WithASideOfSalt/EE475-ORBITS/README.md

# EE475-ORBITS
Development Repository for EE475 ORBITS project, design and implementation
