WithASideOfSalt/EE475-ORBITS/Design/Report/DesignReport.tex

\documentclass[a4paper,12pt,titlepage]{report}
\usepackage{titling}
\usepackage{amsmath,amssymb}
\usepackage{graphicx}
\usepackage[left=20mm,right=20mm,top=15mm,bottom=15mm]{geometry}
\usepackage{caption}
\usepackage{subcaption}
\usepackage{siunitx} % For clean units formatting
\usepackage{titlepic}
\usepackage{ragged2e}
\usepackage{pdflscape}
\usepackage{hyperref}
\usepackage{caption}
\usepackage{pdfpages}
\usepackage{tikz}
\usepackage[toc, page]{appendix}

\usepackage[backend=biber]{biblatex}
\addbibresource{references.bib}

\usepackage{chngcntr}
\counterwithout{figure}{chapter}
\counterwithout{table}{chapter}
\counterwithout{equation}{chapter}

\usepackage{listings}
\usepackage{xcolor}

\counterwithout{figure}{chapter}
\counterwithout{table}{chapter}
\counterwithout{equation}{chapter}

% --- Title Info ---
\title{EE475 - ORBITS Design}
\author{Scott McBride --- 202215222}
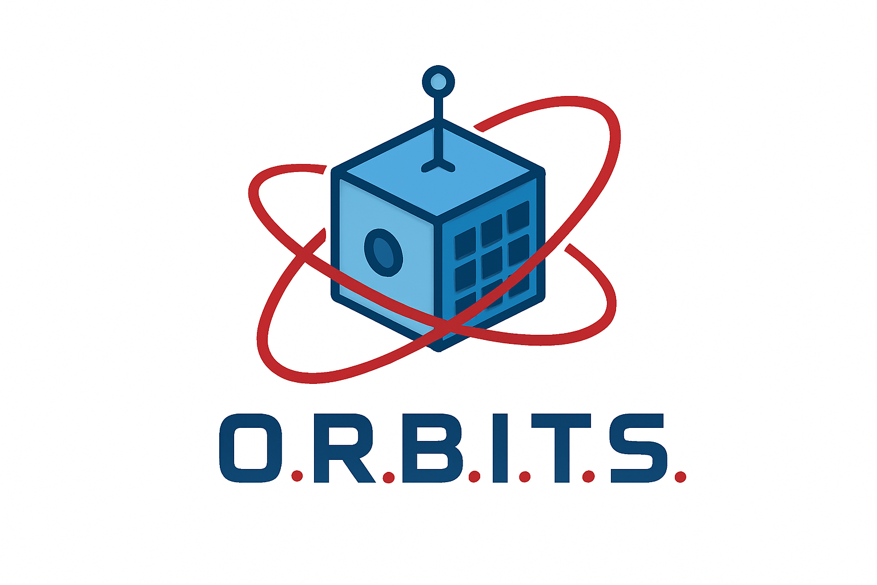
[picture p1: Design/Report/Images/ORBITS_Logo.png]
\titlepic{}
\date{\today}

\begin{document}
\begin{titlepage}
    \begin{center}
        \vspace*{3cm}
        \begin{minipage}{0.8\textwidth}
            \justifying
            \noindent \color{gray}
            I hereby declare that this work has not been submitted for any other degree/course at this University or any other institution and that, except where reference is made to the work of other authors, the material presented is original and entirely the result of my own work at the University of Strathclyde under the supervision of Dr Astrid A Werkmeister.”
        \end{minipage}
        \vfill
        \Huge
        \textbf{ORBITS}
            
        \vspace{0.5cm}
        \LARGE
        Outreach and Research Build for Interactively Teaching Satellites
            
        \vspace{1.5cm}
            
        \begin{figure}[!h]
            \centering
            \begin{minipage}{0.4\textwidth}
                \centering
                
            \end{minipage}
            \begin{minipage}{0.4\textwidth}
                \centering
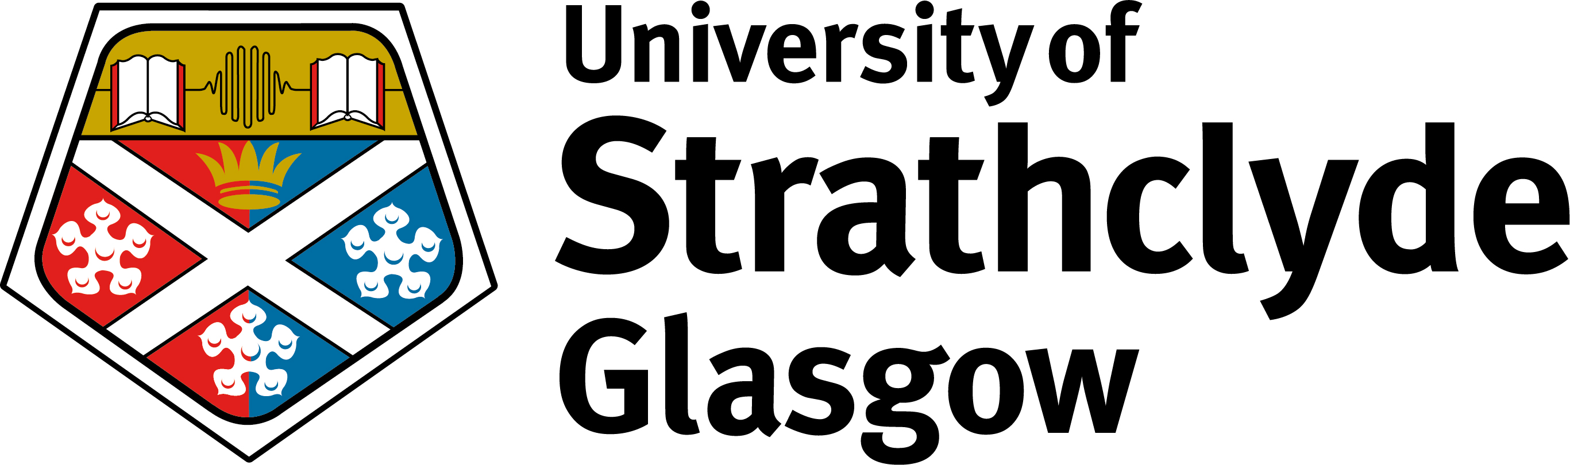
[picture p2: Design/Report/Images/strath_main.jpg]
                
            \end{minipage}
        \end{figure}  

        \textbf{Scott McBride} \\
        Dr Astrid A Werkmeister\\

        \vspace{0.8cm}
            
        \Large
        Department of Electronic and Electrical Engineering\\
        University of Strathclyde\\
        \today
            
    \end{center}
\end{titlepage}
\tableofcontents
\newpage
{\Huge\textbf{Acronyms}}
\begin{table}[h]
    \centering
    \begin{tabular}{|c|c|}
    \hline
    \textbf{Acronym}&\textbf{Meaning}\\
    ADCS & Attitude Determination and Control Subsystem \\
    API & Application Programming Interface \\
    BDD & Block Definition Diagram \\
    BLE & Bluetooth Low Energy \\
    COTS & Commercial Off The Shelf \\
    GPIO & General Purpose Input/Output \\
    I2C & Inter-Integrated Circuit \\
    IMU & Inertial Measurement Unit \\
    OBC & On-Board Computer \\
    PCB & Printed Circuit Board \\
    PMAD & Power Management and Distribution Subsystem \\
    RF & Radio Frequency \\
    SPI & Serial Peripheral Interface \\
    SysML & Systems Modelling Language \\
    UART & Universal Asynchronous Receiver-Transmitter \\
    UML & Unified Modeling Language \\
    \hline
    \end{tabular}
\end{table}
\chapter{Abstract}
The Outreach and Research Build for Interactively Teaching Satellites, referred to as ORBITS herein, is an emulation system for a 1U CubeSat ecosystem including both a ground communication station and a physical ORBITS unit that provides a learning environment for both software and hardware concepts.

The ORBITS project is looking to develop a class-based learning material that pupils, students, teachers and lecturers are able to gain hands-on experience with to experiment, learn and research into CubeSat development. The ORBITS system looks to have modularity at the forefront of its design, allowing users to create their own payloads to interact with a stock unit to learn about different aspects of a CubeSat system and development. The system looks to be comprised of Commercial Off The Shelf (COTS) components where possible to keep costs low and allow for easy replacement of faulty parts.

Where applicable SysML diagrams have been used to represent the design of the ORBITS system to describe and provide an alternative method of understanding for users to reference.

\chapter{Introduction}

The Space industry around Scotland looks to increase the number of employees to \(20,000\) and targeting \pounds 4 billion in global market share by 2030~\cite{govScot}. To meet this growth within the industry high quality educational materials are needed to introduce young individuals to what they may be working on within the industry.

ORBITS, the Outreach and Research Build for Interactively Teaching Satellites, is a developmental tool for students to learn about satellite systems and their operation through physical experimentation and learning. The particular type of satellite being emulated by this device is a 1U CubeSat, a standardised type of nanosatellite that is becoming increasingly popular for its low cost and accessibility for companies and educational institutions to develop and launch their own satellites.

ORBITS provides both the software and hardware learning solutions to best prepare those looking for a career in the space industry and inspire those looking to learn about space and satellite systems. The system is designed to be modular allowing for users to create their own payloads to interact with a stock unit to learn about different aspects of a CubeSat system and development. COTS components are used throughout the design of this system to keep costs low and simplify maintenance. 

The system provides a seamless user experience from any standard laptop or desktop environment through a ground station that links to the ORBITS unit mimicking a real-world remote satellite communication network. This provides both a software development environment and a source for the learning materials for the system.

This report covers a review of related work, requirement definition, hardware design, software design and prototype evaluation.

\section{Project Objectives}

Outlined in Table \ref{tab:project_objectives} are the project objectives for the ORBITS project. These objectives were defined through consultation with the teaching staff most likely to be interacting with these systems within a classroom environment and seeing common sticking points with integrating new projects within the class, like time for set-up, ease of use during learning and both debugging of hardware and software related issues. These objectives were then prioritised based on their importance to the overall project and the learning experience of users. The major objectives are those that are essential for the functionality of the system and the learning experience, while the minor and optional objectives are those that would enhance the system but are not essential for its core functionality.

\begin{table}[h]
\centering
\caption{ORBITS Project Objectives}
\label{tab:project_objectives}
\begin{tabular}{|p{10cm}|c|}
\hline
\textbf{Project Objective} & \textbf{Importance} \\ \hline
Provide a prototype ORBITS unit composed of Commercial Off the Shelf (COTS) components where possible. & Major \\ \hline
Provide pilot demonstrations that shall showcase the functionality and purpose of the satellites that ORBITS has been made to emulate. Use understanding of EE105 learning outcomes to aid in project aims and objectives. & Major \\ \hline
Provide a ``Base Station'', a way of communicating between a standard electronic device and the ORBITS unit. & Major \\ \hline
Provide relevant software to reduce the barrier of entry to use the product. & Major \\ \hline
Develop and design both software and hardware architecture for systems and decompose into relevant subsystems. & Major \\ \hline
Provide product documentation to allow ease of future work based upon this project. & Major \\ \hline
Provide ``Hot Swappable'' modules each with a payload with functionality related to the space industry. & Minor \\ \hline
Provide additional, more complicated modules to aid in the experimentation of different concepts. & Optional \\ \hline
Provide a viability study into how a product like this could break out into market, creating a financial incentive for future work. & Optional \\ \hline
\end{tabular}
\end{table}

\chapter{Review of Related Work}

Firstly, it is important to understand what a CubeSat actually is and why they are important for the space industry. A CubeSat is a type of nanosatellite that is typically constructed in standard units of 10 cm x 10 cm x 11.35 cm, known as 1U. The reason for this standardisation is to allow for easier development and launch of these satellites as they can fit within a standardised deployment mechanism. These devices are typically launched to low orbit (\(<2000\) km \cite{LEO}).

CubeSats were first developed at the California Polytechnic State University, San Luis Obispo and Stanford University's Space Systems Development Lab in 1999 \cite{cubesat_org}. Using this initial work as a basis, the CubeSat standard was developed and released in 2004 with over 2900 CubeSat missions launched as of January 1st 2026 \cite{nanoSats_eu}. Shown in Figure \ref{fig:CubeSat_Missions} is a visual representation of the growth in CubeSat missions over time.

\begin{figure}[h]
    \centering
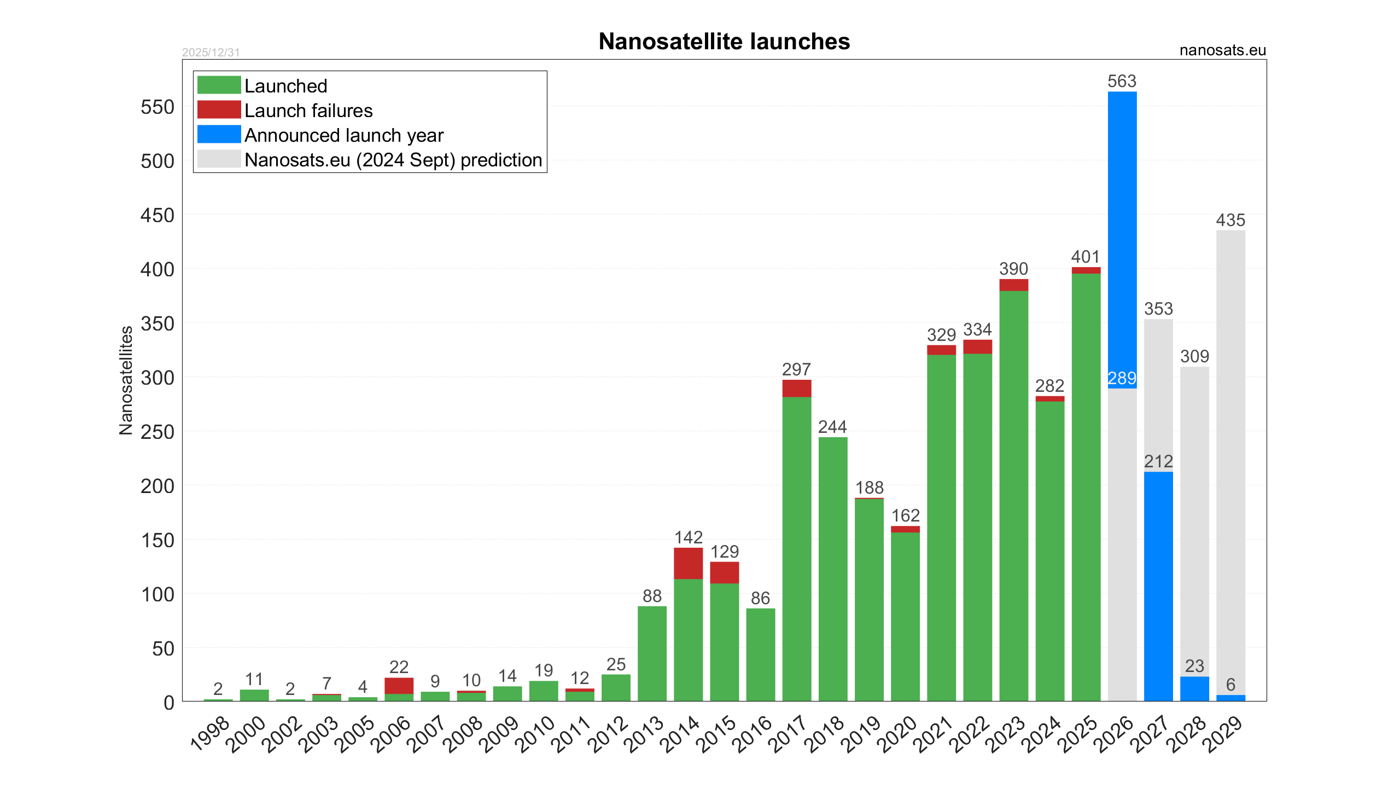
[picture p3: Design/Report/Images/CubeSat_Missions.png]
    
    \caption{Growth in CubeSat Missions over time~\cite{nanoSats_eu}}
    \label{fig:CubeSat_Missions}
\end{figure}

This standard has allowed for the development of CubeSats to be more accessible for companies and educational institutions to develop and launch their own satellites. The CubeSat standard has also allowed for the development of a wide range of different types of CubeSats including those for Earth observation, communication, technology demonstration and scientific research.

CubeSats have become increasingly popular for their educational institutions due to the low cost nature of the development of these satellites with projects like the EduCube \cite{EduCube_1U} and UBO \cite{UBO} projects. These projects looked to provide Masters students hands on experience developing and learning with physical hardware based on usable standards within the industry. These projects have been successfully implemented into academia, and look to emulate every minute detail of a space ready model. This complexity relegates these types of projects for final year students with many hours of learning and research within the field.

To further increase the scope of teaching CubeSats a few criteria should be considered. The cost of the hardware, the amount of learning materials and the extensibility of functionality are all important when it comes to the development of such devices.

Products that look at the commercial and educational markets do exist on the market already, however they are often either very expensive, don't provide a ground station to satellite link or both. Take the Ukrainian made MySat for example~\cite{MySat}, a 1U CubeSat emulator that provides a physical unit for users to interact with and construct themselves. However it is quite expensive at around \pounds 300 for the kit targeted to universities and the main method of interaction is directly to the unit rather than from a ground station connection. This means that users are limited in the software development they can do with the unit and are not able to experience the full satellite development process.

Another example is the Australian made RASCube~\cite{RASCube}, a 1U CubeSat that provides field tested hardware within the design. The RASCube provides extensive learning materials and functionality but due to the nature of being designed from the ground up with completely custom PCBs the cost of a unit including all of the learning materials is around \pounds 1000 for a singular kit which may not be accessible for many educational institutions and individuals looking to learn about satellite systems. Despite this price point, the feature set and demand for high quality learning has driven more than 1400 kits sold \cite{RASCube}.

These products highlight a clear gap within the market: an affordable, ground-station linked CubeSat kit accessible to those with little to no prior experience, including first year undergraduates. ORBITS looks to provide an interactive teaching experience particularly focused on those with less experience to inspire and educate around the space industry.

Additional projects within space education do exist, such as the open source ISS Mimic~\cite{ISS-Mimic}, a project that looks to mimic the telemetry data from the International Space Station (ISS), using a 3D printed scale model, on-board microcontroller and motors to provide a physical representation of the ISS. The data used to create this model is from a subset of the real ISS telemetry data and is publicly available through \href{https://lightstreamer.com/}{Lightstreamer}, an event broker used to deliver real-time data to customers. 

\chapter{Design}
The ORBITS system has been developed using a top down approach starting with the high level requirements and breaking these down into smaller, more specific system requirements. The process first began by consulting the teaching staff most likely to be interacting with these systems within a classroom environment and seeing common sticking points with integrating new projects within the class, like time for set-up, ease of use during learning and both debugging of hardware and software related issues.

To begin, without a CubeSat emulation device, referred to as an ORBITS unit, there would be limited work that a student could perform. There needs to be some physical device that the user can interact with to be able to perform the relevant learning. This can then be decomposed into what subsystems/requirements need to be available within the ORBITS unit to be effective as both a learning tool while emulating a real-world CubeSat. These include,
\begin{itemize}
    \item \textbf{Power Management:} Within a CubeSat power needs to be constantly managed due to the harsh conditions and limited resources while in space. This includes the storage of on-board power and the distribution to each subsystem within the CubeSat.
    \item \textbf{Communication:} Some method to communicate between the ground station and the ORBITS unit that mimics the operation of an operational CubeSat including the protocol and data formatting.
    \item \textbf{Fitness to Form:} Allows the user to work with an industry-standard of the 1U form factor (10cm x 10cm x 11.35cm) while reducing the need for large models within the classroom.
    \item \textbf{On-Board Computer:} The on-board computer allows the system to operate and monitor the other components and subsystems. This can then allow for monitoring and telemetry data to be provided back to the user.
    \item \textbf{Attitude Determination and Control:} Within space a CubeSat is required to reorient itself to constantly optimise the power gain from the solar panels or provide optimal orientation for data collection from the payload. This then provides students with an introduction to control systems.
\end{itemize}

Another of the high level requirements is the use of COTS components. Commercial off the shelf, otherwise known as COTS, components are ready-made hardware and software solutions that are ready to be integrated into projects. In this case, COTS components can be leveraged to reduce the overall cost of an ORBITS unit by providing this ready-made solution. Additionally, by using COTS components design becomes more repairable as direct replacements can be sourced. This is beneficial where only small replacements within a unit are needed to be made rather than a full unit.

Experimentation facilitation was also required when considering the design of the ORBITS system. Without this the teaching capabilities of the system would be severely hindered defeating the purposes of creating ORBITS in the first place. Two main methods can be used to achieve this, both taking a different route. The hardware approach is allowing for a user defined payload to be integrated into the system. This allows for hands on experience that a student can get the satisfaction of building themselves. The software approach is allowing the ORBITS unit to be reprogrammable to allow users to interact with the system in different, unique ways.

Finally, data processing and visualisation is required for this system. Without it the user wouldn't be able to get feedback from the system they have constructed, reducing the effective learning achievable from this system. To enable the data processing and visualisation, the ground station will be a device capable of hosting and sharing its own web-based application to allow the user to interact with the system.

Together these requirements form the basis of the ORBITS requirement architecture, the full derivation of which is shown in Figure \ref{fig:ORBITS_Requirements} 

\newgeometry{
    top = 0cm,
    bottom = 0 cm,
    left = 2 cm,
    right = 0 cm
}
\begin{landscape}
  \thispagestyle{empty}  
    \begin{figure}[h]
        \centering
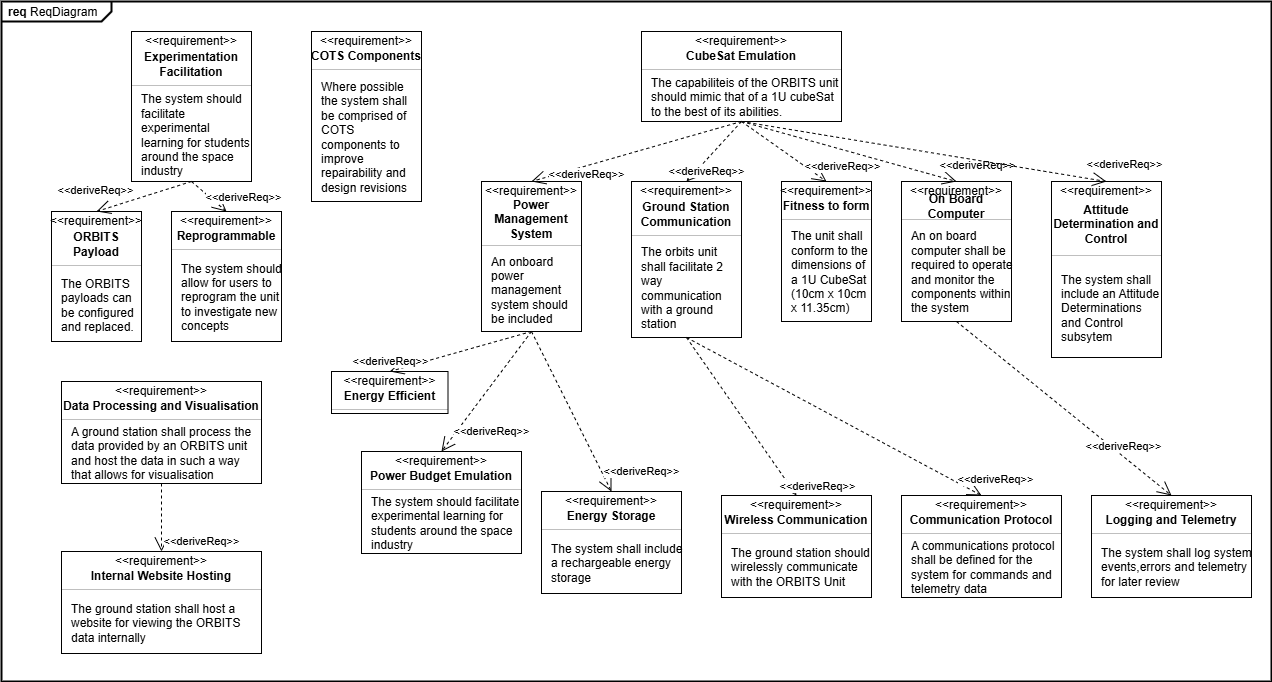
[picture p4: Design/Report/Images/Block Definition Diagram.png]
        
        \caption{High Level ORBITS System Requirements}
        \label{fig:ORBITS_Requirements}
    \end{figure}
  \vfill 
  \begin{center}
    \thepage
  \end{center}
\end{landscape}
\restoregeometry

From these high level requirements the system can be broken down into the separate subsystems that are needed to meet the requirements. These subsystems include:
\begin{itemize}
    \item On-Board Computer (OBC)
    \item Power Management and Distribution Subsystem (PMAD)
    \item Communications Subsystem
    \item Attitude Determination and Control Subsystem (ADCS)
    \item Payload
    \item Platform Structure
\end{itemize}

To support experimentation and learning, a ground station is also needed to provide the users an easy way to interact with the ORBITS unit and learning materials. This ground station is a separate device that enables the connection to an ORBITS unit from any standard laptop or desktop environment.

Throughout the design of the ORBITS system the use of the Systems Modelling Language \cite{SysML}, or SysML for short, has been used to provide the visual representation of the system and its components. SysML is a visual modelling language used by systems engineers to model complex systems and has been derived and extended from the Universal Modeling Language (UML). To start a model for both the ORBITS unit and ground station were defined in Figure \ref{fig:ORBITS_BDD}.
\begin{figure}[h]
    \centering
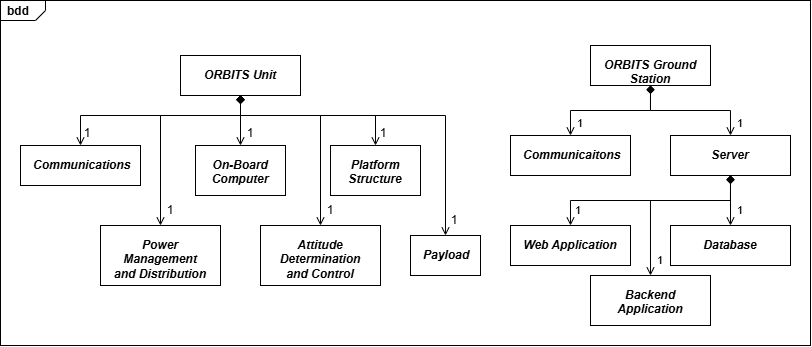
[picture p5: Design/Report/Images/Logical-Structure.png]
    
    \caption{ORBITS Unit and Ground Station Block Definition Diagram}
    \label{fig:ORBITS_BDD}
\end{figure}

Each of these subsystems are used to represent what is actually needed for the system to function. In the case of the ground station, each subsystem may not be a physical component but rather a software component for instance the hosted database for operating data of the ORBITS unit.

Shown below in Figure \ref{fig:ORBITS_IBD} is the internal block diagram for the ORBITS unit showing the physical connections between the different subsystems. The ground station is not included within this diagram as it is a separate device that connects to the ORBITS unit through wireless communication.
\begin{figure}[h]
    \centering
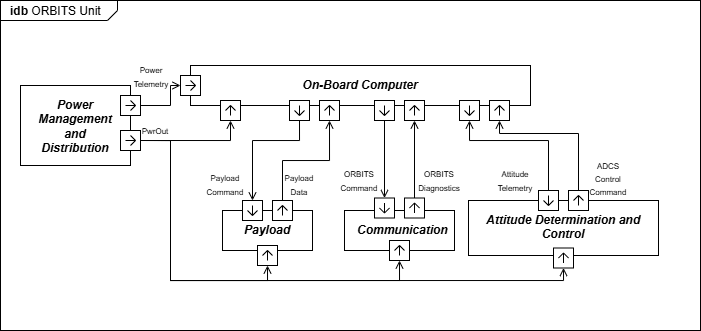
[picture p6: Design/Report/Images/Internal-Block-Diagram-Unit.png]
    
    \caption{ORBITS Unit System Internal Block Diagram}
    \label{fig:ORBITS_IBD}
\end{figure}
Defining the system in this way creates a clear structure as to how the dedicated ORBITS unit should behave ensuring that relevant learning materials can be developed for each subsystem.

\section{Hardware Overview}
This section looks to cover the hardware design of the ORBITS system. The design of the hardware is based on the requirements defined in the previous section and particularly to ensure the repairability of the ORBITS unit and ground station, COTS components have been used where possible. This design principle allows for ready-made hardware solutions to be integrated into the system, reducing overall costs and simplifying maintenance.

\section{Hardware Selection and Subsystem Design}
Taking these general design choices into account, each subsystem has been researched and designed to meet the overall system requirements. Each subsystem design is outlined in the following sections. Each section, where relevant, considered multiple options and comparing against several categories. Each category also has a relevant weighting when deciding on the final selection. These categories are shown in \ref{tab:selection_criteria_weighting}:
\begin{table}[h]
\centering
\caption{Selection criteria and weighting}
\label{tab:selection_criteria_weighting}
\begin{tabular}{|p{4cm}|p{8cm}|c|}
\hline
\textbf{Category} & \textbf{Description} & \textbf{Weighting} \\ \hline
Cost & The monetary cost of the component or subsystem. & 5 \\ \hline
Performance & The performance of the component or subsystem in terms of its capabilities and specifications. & 4 \\ \hline
Availability & The availability of the component or subsystem in the market. & 3 \\ \hline
Price to Performance & The ratio of the cost to the performance of the component or subsystem. & 3 \\ \hline
Ecosystem & The availability of learning materials, documentation and community support for the component or subsystem. & 2 \\ \hline
\end{tabular}
\end{table}

The components listed within each subsystem are those that were the best fit from these categories resulting in their selection for the ORBITS project.

\subsection{Ground Station}
The ground station is the interface between the user and the ORBITS unit. It provides a platform for users to develop software and interact with the ORBITS unit. The ground station needs to be as accessible as possible for a wide range of different users including students, teachers and lecturers with particular focus on first year undergraduates. To achieve this the ground station should be an add on device with connectivity to any standard laptop or desktop environment.

Shown below in Table \ref{tab:ground_station_selection_matrix} is the major component selection for the main ground station computer. Each component being compared gains a score out of 10, with 1 being the least applicable to the application and 10 being the most. As previously mentioned, each category also has a weighting value to prioritise different characteristics.

\begin{table}[h]
\centering
\caption{Ground Station Selection Matrix}
\label{tab:ground_station_selection_matrix}
\begin{tabular}{|p{3cm}|c|c|c|c|c|p{2.5cm}|}
\hline
\textbf{Option} & \textbf{Cost} & \textbf{Ecosystem} & \textbf{Performance} & \textbf{Avail.} & \textbf{P/P} & \textbf{Decision} \\ \hline
Raspberry Pi Zero 2 W & 10 & 8 & 5 & 8 & 10 & Selected \\ \hline
K2B Allwinner H618 & 5 & 3 & 5 & 7 & 5 & Rejected \\ \hline
Orange Pi Zero 2 W & 7 & 6 & 6 & 7 & 7 & Rejected \\ \hline
\end{tabular}
\end{table}

Shown below in Table \ref{tab:ground_station_selected_components} are the selected components for the ground station subsystem. These components include the Raspberry Pi Zero 2W, a small single-board computer containing an ARM Cortex-A53 clocked at 1GHz with on-board Wifi and Bluetooth, acting as the main ground station computer. To support the wireless connectivity already on-board and give an analogue for the communication technology on a mission ready CubeSat, the NRF24L01+ module has been included. This 2.4 GHz transceiver is used purely as the connection between the ground station and ORBITS unit during a mission. 
\begin{table}[h]
    \centering
    \caption{Selected components for the Ground Station}
    \label{tab:ground_station_selected_components}
    \begin{tabular}{|p{4cm}|p{4cm}|p{6cm}|}
    \hline
    \textbf{Component} & \textbf{Part Number} & \textbf{Key Specifications} \\ \hline
    Ground Station & Raspberry Pi Zero 2 W & 1~GHz ARM Cortex-A53, 512~MB SDRAM, 2~W active load \\ \hline
    Communication Module & NRF24L01+ & 2.4~GHz RF band, 250~kbps data rate \\ \hline
    Housing & 3DRPiHousing & Open-source 3D print~\cite{GroundStationCase} \\ \hline
    \end{tabular}
\end{table}

For the communications of the system more context will be provided in the communications subsystem section \ref{communications_subsystem} as the unit contained within both the ground station and ORBITS unit are the same, preventing redundant discussion.

Even though the Raspberry Pi Zero 2 W is not the most powerful option available it was selected for its low cost, large ecosystem and high price to performance ratio in comparison to the other options. The availability of the Raspberry Pi Zero 2 W is also very high with the device being available from a wide range of retailers and distributors while being at a price point that helps minimise the overall cost of an ORBITS kit.

Due to the nature of the Raspberry Pi being a fully featured single board computer it allows for the hosting of all the relevant materials needed for the ORBITS system including compiling user generated software. The Raspberry Pi Zero 2 W provides the following interfaces relevant to the ORBITS system:

\begin{itemize}
    \item \textbf{Electrical interface:} 5~V input, 2~A max current, overcurrent protection. Allows for power to be supplied by standard USB-A port on laptop or desktop.
    \item \textbf{Data interface:} USB 2.0 (480~Mbps), 2.4GHz 802.11 wireless LAN, Bluetooth LE 4.2. Allows for connectivity between both the development device and wireless connection to the ORBITS unit.
    \item \textbf{Mechanical interface:} 30 mm x 65 mm board, 4 mounting holes, micro-USB power and data port. Small size allows for easy storage and manoeuvrability with development device. 
    \item \textbf{Software interface:} Raspberry Pi OS (Linux \- Headless Configuration), USB Gadget mode for host connectivity. This allows for the system to be developed like a readily available linux based server.
\end{itemize}

\subsubsection{Summary}

To allow for the software and development environment to be as accessible as possible the ground station had been selected to interface with any standard laptop or desktop environment. To provide the maximal flexibility the Raspberry Pi Zero 2 W was selected as the ground station. The Raspberry Pi Zero 2 W is a low cost, low power single board computer that provides a wide range of connectivity options including WiFi and Bluetooth shown in figure~\ref{fig:PiZero2W}. The Raspberry Pi Zero 2 W also has a large community and ecosystem of learning materials and documentation which makes it an ideal choice for the ground station.
\begin{figure}[h]
    \centering
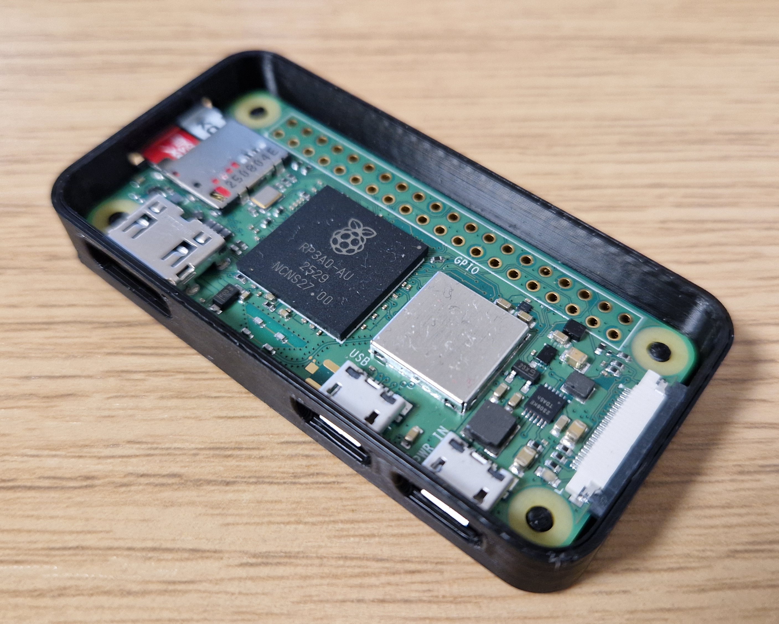
[picture p7: Design/Report/Images/PiZero2W.jpg]
    
    \caption{Raspberry Pi Zero 2 W with 3D printed case}
    \label{fig:PiZero2W}
\end{figure}

As this device is a fully featured single board computer it allows for the hosting of the relevant materials needed for the ORBITS system including the user generated software. The low power nature also means that when connecting to an external computer via the micro-USB port the device will have minimal effects on the battery life of the host computer. To enable the connection between the development machine and the ground station through the USB port the Raspberry Pi can be configured to operate in USB gadget. This enables the development machine to access the website being hosted on the Raspberry Pi, more details on this can be found in the Software Design section of this report, \ref{software_design}.

\subsection{On-Board Computer}

The On-Board Computer (OBC) is the main processing device for the ORBITS unit. It is responsible for managing the operations of the ORBITS unit and ensuring the system is operating as required. The OBC needs to be able to handle the processing requirements of the unit while also being low power and cost effective. Shown in Table \ref{tab:obc_selection_matrix} is the major component selection for the main OBC computer.

\begin{table}[h]
\centering
\caption{On-Board Computer Selection Matrix}
\label{tab:obc_selection_matrix}
\begin{tabular}{|p{3cm}|c|c|c|c|c|p{2.5cm}|}
\hline
\textbf{Option} & \textbf{Cost} & \textbf{Ecosystem} & \textbf{Performance} & \textbf{Avail.} & \textbf{P/P} & \textbf{Decision} \\ \hline
Raspberry Pi Pico 2 W & 9 & 10 & 5 & 6 & 7 & Rejected \\ \hline
Raspberry Pi Pico 2 & 8 & 10 & 5 & 6 & 6 & Rejected \\ \hline
ESP32-S3 & 6 & 8 & 7 & 10 & 9 & Selected \\ \hline
\end{tabular}
\end{table}

The selected components for the OBC are shown in Table \ref{tab:obc_selected_components}.
\begin{table}[h]
    \centering
    \caption{Selected components for the On-Board Computer}
    \label{tab:obc_selected_components}
    \begin{tabular}{|p{4cm}|p{4cm}|p{6cm}|}
    \hline
    \textbf{Component} & \textbf{Part Number} & \textbf{Key Specifications} \\ \hline
    OBC & ESP32-S3-N8R8-1U & Dual-core 240~MHz, 512~KB SRAM, 8~MB flash, WiFi/BLE \\\hline
    Real-Time Clock & PCF8523 & \(I^2C\) Real-Time Clock based on a 32.768 kHz quartz crystal\\\hline
    \end{tabular}
\end{table}

The ESP32-S3 was selected for the OBC due to its low cost, high performance and wide range of integrated connectivity with simple development through the Arduino Integrated Development Environment (IDE) opening learning material to many open source libraries for components and features. 

\begin{itemize}
    \item \textbf{Electrical interface:} 3.3~V input, 500~mA max current, overcurrent protection. Low power with on-board buck converter for voltage conversion from 5V input to required 3.3V input.
    \item \textbf{Data interface:} UART, I2C, SPI, WiFi 802.11 b/g/n, Bluetooth LE 5.0. These allow for different connections to be made to the microcontroller meaning many devices can be integrated into the base system along with payloads. Also allows for wireless reprogramming through a local area network connection.
    \item \textbf{Mechanical interface:} 25.4 mm x 62.74 mm board, 38 GPIO pins. Plenty of connectivity for control of the base unit and user defined payloads all within a form factor that fits within the designed frame.
    \item \textbf{Software interface:} ESP-IDF (C/C++), Arduino IDE support, PlatformIO support, FreeRTOS-based OS, extensive peripheral libraries.
\end{itemize}

There are several variants of the ESP32-S3, with variants having different amounts of flash memory and Pseudo-Static RAM (PSRAM) and on-board antenna. The specific variant chosen was the ESP32-S3-N8R8-1U which has 8MB of both flash memory and PSRAM. This variant also allows for the connecting of an external antenna through an IPEX connection to increase the range for the on-board WiFi and Bluetooth while reducing the size of the pcb. Shown in Figures~\ref{fig:ESP32-S3-Docs}~\cite{ESP32-S3_Documentation} and~\ref{fig:ESP32-S3-1U} is the technical image for the ESP32-S3 detailing the pin layout and features for the device and an image of the specific variant being used within the ORBITS unit.

\begin{figure}
    \centering
    
    \caption{ESP32-S3 pin specification}
    \label{fig:ESP32-S3-Docs}
\end{figure}

\begin{figure}
    \centering
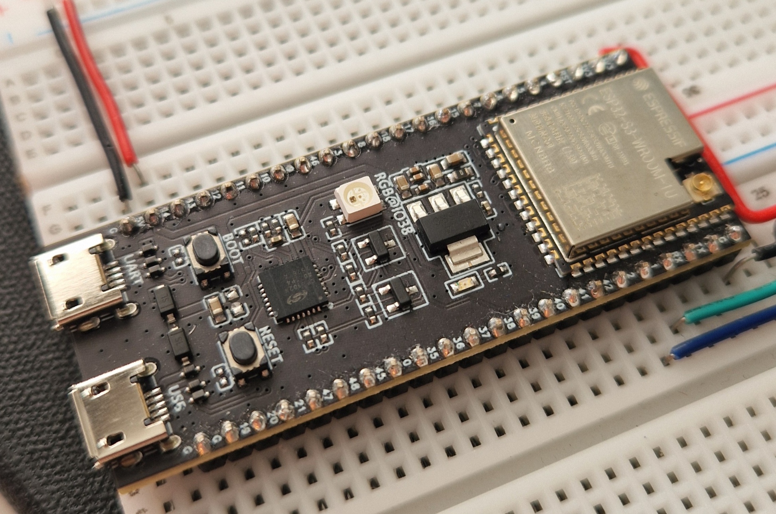
[picture p9: Design/Report/Images/ESP32-S3-WROOM-1U.jpg]
    
    \caption{ESP32-S3-WROOM-1U OBC Microcontroller}
    \label{fig:ESP32-S3-1U}
\end{figure}

Of particular note with this microcontroller is the addition of 2 I2C buses. I2C is a popular synchronous 2 wire communication protocol that can allow for several devices to be controlled through minimal pins connected to the controller. Each device connected to the bus has an address defined by the manufacturer that can be used to interact with the components registers, usually to access the data contained within a sensor or to set component characteristics. By having 2 of these I2C buses included within the device it can allow for internal communications to be handled by one while the other is purely used for communications to the user defined payload.

In addition to the on-board computer a PCF8523 breakout board is included within the system. This is to provide a highly accurate external clock signal external to that of the microcontroller using a \(32.768 kHz\) quartz crystal. The reason for this addition into the system is because of the unreliability with the application. Using the internal clock can lead to a few issues, namely inaccuracies in timing, device reset causes the epoch time to reset to zero and, finally, the timings can drift depending on temperature of the environment.

To mitigate all of these issues, an external real-time clock signal can be provided, in this situation a PCF8523. This external clock is very cost effective in an ORBITS unit as it is much cheaper than the alternatives. However, at this price point the PCF8523 exhibits a drift of approximately 2 seconds per day. This drawback does not affect the operation of an ORBITS unit as operation may only last from a few seconds to a few minutes with rapid developments making this external clock very cost effective. Shown in Figure~\ref{fig:PCF8523} is the PCF8523 breakout board used within the ORBITS unit.
\begin{figure}[h]
    \centering
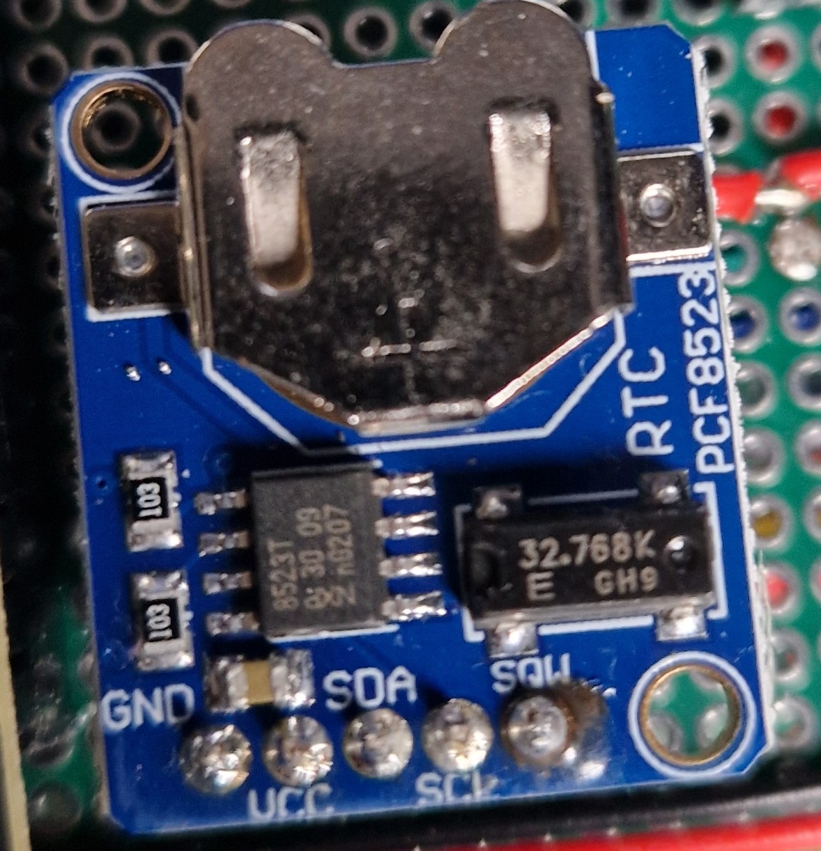
[picture p10: Design/Report/Images/PCF8523.jpg]
    
    \caption{PCF8523 Real-Time Clock Breakout Board}
    \label{fig:PCF8523}
\end{figure}

\subsection{Communications Subsystem}\label{communications_subsystem}

Communications are integral for the operations of this CubeSat system. Implemented within the system are 2 forms of inter-device communication. WiFi, being one of them, is included with both the ground station and OBC with the ground station being able to generate its own WiFi network that the OBC can connect to.

With WiFi being included in both the ground station and OBC, this allows for a simple method of communication between the two devices. The WiFi connection can be used to send commands from the ground station to the OBC and receive telemetry data back from the OBC. This allows for a seamless user experience as users can interact with the ORBITS unit from any standard laptop or desktop environment without the need for additional hardware or software.

However, within CubeSat development WiFi is not the best analogue for space communication. To give an alternative communication method more in line with a CubeSat a wireless RF transceiver module has been included with both the ground station and ORBITS unit.

Shown below in Table \ref{tab:comms_selection_matrix} is the component selection matrix for the communications subsystem. 

%Selection matrix
\begin{table}[h]
\centering
\caption{Communications Transceiver Selection Matrix}
\label{tab:comms_selection_matrix}
    \begin{tabular}{|p{3cm}|c|c|c|c|c|p{2.5cm}|}
    \hline
    \textbf{Option} & \textbf{Cost} & \textbf{Ecosystem} & \textbf{Performance} & \textbf{Avail.} & \textbf{P/P} & \textbf{Decision} \\ \hline
    NRF24L01+ & 10 & 9 & 6 & 10 & 10 & Selected \\ \hline
    LoRa SX1276 & 5 & 7 & 9 & 8 & 6 & Rejected \\ \hline
    HC-12 & 8 & 7 & 5 & 8 & 7 & Rejected \\ \hline
\end{tabular}
\end{table}

The NRF24L01+ was selected, shown in figure~\ref{fig:NRF24L01}, was selected as the RF transceiver for the ORBITS system and is a low cost, low power RF transceiver that fits the requirements needed by the ORBITS system. Even though the LoRa SX1276 has better performance in terms of data rate and range, the NRF24L01+ was selected for its low cost, large ecosystem and high price to performance ratio in comparison to the other options. The availability of the NRF24L01+ is also very high with the device being available from a wide range of retailers and distributors while being at a price point that helps minimise the overall cost of an ORBITS kit.
\begin{figure}[h]
    \centering
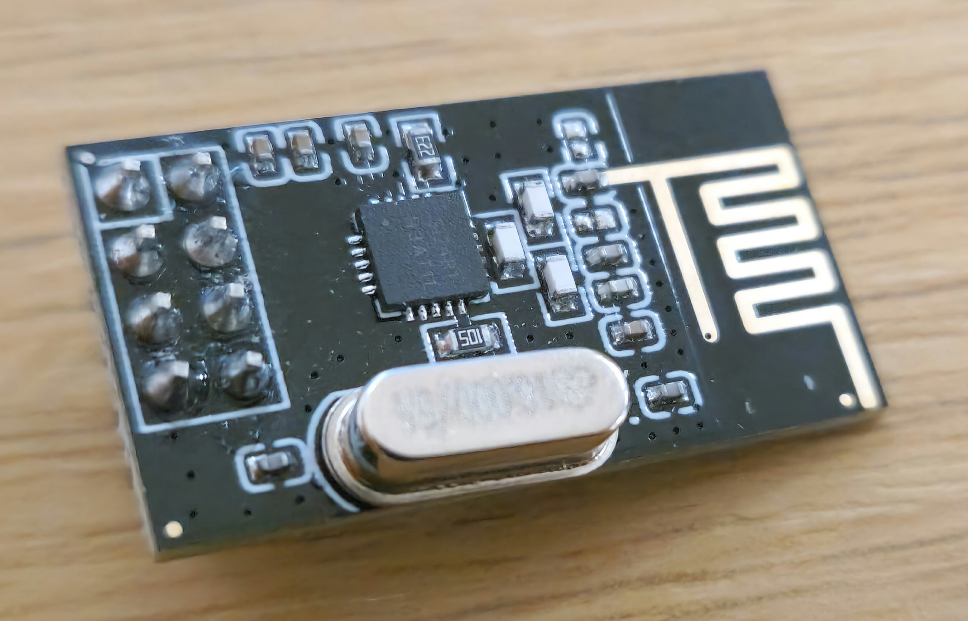
[picture p11: Design/Report/Images/NRF24L01.jpg]
    
    \caption{NRF24L01+ RF Transceiver Module}
    \label{fig:NRF24L01}
\end{figure}
The 2.4GHz frequency band used by the module allows for easy communication without the need for a license. The NRF24L01+ is able to achieve data rates of up to 2Mbps which is more than sufficient for the needs of the ORBITS system. The module also has a range of up to 100m in open space which is more than enough for a classroom environment. Due to the inexpensive nature of the module it has been widely used in the maker community and has a large ecosystem of learning materials and documentation which makes it an ideal choice for the ORBITS system.

\begin{itemize}
    \item \textbf{Electrical interface:} 3.3~V input, 115~mA max current during transmission, low power sleep modes. This allows for the module to be powered directly from the OBC and ground station with minimal impact on the overall power consumption of the system.
    \item \textbf{Data interface:} SPI for communication with the OBC and ground station microcontrollers. This allows for fast and efficient communication between the module and the microcontrollers.
    \item \textbf{Mechanical interface:} 34 mm x 17 mm x 5 mm module, 8-pin header for SPI and power connections. The small size of the module allows for easy integration into the ORBITS unit and ground station.
\end{itemize}

\subsection{Power Management and Distribution Subsystem (PMAD)}

The power management and distribution (PMAD) subsystem is responsible for managing the power within the ORBITS unit. This includes the storage of on-board power and the distribution to each subsystem within the CubeSat. The PMAD should also contain some method of monitoring the power levels within the system to provide feedback to the user in addition to allowing connectivity to solar panels for power generation. Shown in \ref{tab:pmad_selection_matrix} and \ref{tab:pmad_selected_components} are the component selection matrix for the PMAD subsystem and the selected components for the PMAD subsystem respectively.

\begin{table}[h]
\centering
\caption{Power Management and Distribution Selection Matrix}
\label{tab:pmad_selection_matrix}
    \begin{tabular}{|p{3cm}|c|c|c|c|c|p{2.5cm}|}
    \hline
    \textbf{Option} & \textbf{Cost} & \textbf{Ecosystem} & \textbf{Performance} & \textbf{Avail.} & \textbf{P/P} & \textbf{Decision} \\ \hline
    \href{https://thepihut.com/products/solar-power-management-module-for-6v-24v-solar-panel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}{Solar Power Management Module}  & 5 & 4 & 4 & 6 & 6 & Rejected \\ \hline
    \href{https://thepihut.com/products/adafruit-bq25185-usb-dc-solar-charger-with-5v-boost-board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}{Adafruit bq25185 with 5V Boost} & 5 & 7 & 7 & 6 & 5 & Rejected \\ \hline
    \href{https://thepihut.com/products/adafruit-bq25185-usb-dc-solar-lithium-ion-polymer-charger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}{Adafruit bq25185} & 6 & 7 & 7 & 6 & 9 & Selected \\ \hline
\end{tabular}
\end{table}

The selected components for the PMAD subsystem are shown in Table \ref{tab:pmad_selected_components}.
\begin{table}[h]
    \centering
    \caption{Selected components for the Power Management and Distribution Subsystem}
    \label{tab:pmad_selected_components}
    \begin{tabular}{|p{4cm}|p{4cm}|p{6cm}|}
    \hline
    \textbf{Component} & \textbf{Part Number} & \textbf{Key Specifications} \\ \hline
    Power Management Module & Adafruit bq25185 & 1.2~V to 5.5~V input, 500~mA max charge current, USB and solar charging support \\ \hline
    Battery & 2 18650 cells & 3.7~V nominal voltage, 4000~mAh capacity \\ \hline
    Power Monitoring & INA260 DC Power Monitor & I2C, 36 V max voltage 15 A max current. 0.15\% System Gain Error\\ \hline
    \end{tabular}
\end{table}

The Adafruit bq25185 was selected for the PMAD system due to its low cost and high performance. The module provides support for both USB-C and solar charging which allows for flexibility in how the ORBITS unit can be charged. This is particularly relevant as the classroom environment may not have the necessary equipment to charge the ORBITS unit through solar panels. Shown in Figure~\ref{fig:bq25185} is the bq25185.

\begin{figure}[h]
    \centering
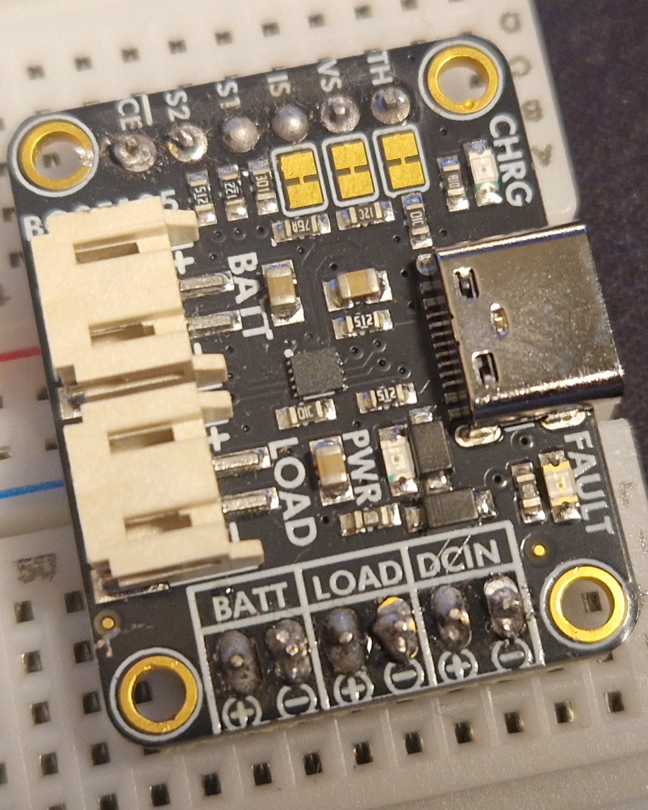
[picture p12: Design/Report/Images/bq25185.jpg]
    
    \caption{Adafruit bq25185 Power Management Module}
    \label{fig:bq25185}
\end{figure}

\begin{itemize}
    \item \textbf{Electrical interface:} 1.2~V to 5.5~V input voltage range, 500~mA maximum charge current, supports USB-C and solar panel input simultaneously. The wide input voltage range allows for flexible charging from both USB and solar sources, with the module regulating the charge current to protect the battery cells.
    \item \textbf{Data interface:} Has 2 status outputs used to determine faults and monitor charging status, readable from simple GPIO pins on pins S1 and S2
    \item \textbf{Mechanical interface:} 31.75mm x 25.4mm Adafruit breakout board with castellated mounting holes. 
\end{itemize}

In addition to the power management module, a power monitoring INA260 module is included within the system. This allows for the monitoring of the power levels within the system and provides feedback to the user through telemetry data. This is particularly important for the learning experience as it allows users to understand the power consumption of their system and how different components affect the overall power usage when creating their own payloads. Shown in Figure~\ref{fig:INA260} is the INA260 power monitoring module.

\begin{figure}[h]
    \centering
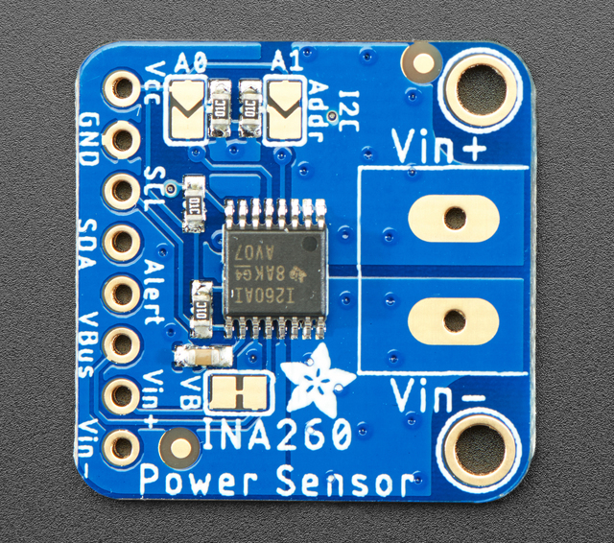
[picture p13: Design/Report/Images/INA260.jpg]
    
    \caption{Adafruit INA260 Power Monitoring Module \cite{Adafruit}}
    \label{fig:INA260}
\end{figure}

\begin{itemize}
    \item \textbf{Electrical interface:} 2.7~V to 5.5~V supply voltage, 36~V maximum bus voltage, 15~A maximum current measurement range with 0.15\% system gain error. Powered directly from the 3.3~V OBC supply with in-line current sensing requiring no additional shunt resistor.
    \item \textbf{Data interface:} I\textsuperscript{2}C with configurable device address. Provides current, voltage and power registers readable directly by the OBC.
    \item \textbf{Mechanical interface:} 22.86~mm x 17.78~mm Adafruit breakout board with two terminal block connections for in-line current measurement. The terminal block connections allow for straightforward integration into the power distribution wiring of the ORBITS unit.
    \item \textbf{Software interface:} Supported by the Adafruit INA260 Arduino library, providing a high level interface for reading current, voltage and power measurements. Data is accessible via the OBC and passed to the telemetry pipeline, allowing students to observe real-time power consumption of their payloads through the ground station web application.
\end{itemize}

\subsection{Platform Structure}

The platform structure is responsible for providing the physical support for the ORBITS unit. This is mainly covered by the frame of the ORBITS unit and the pcbs used to connect the different components together. The structure needs to be able to support the components within the ORBITS unit while also being lightweight, cost effective, easy to manufacture and assemble all while conforming to the 1U CubeSat form factor. The most simple method to create this frame is through 3D printing which allows for a low cost, lightweight and easily manufacturable solution. Shown in Figure \ref{fig:frame_pieces} are the 2 types of connecting pieces used within the frame, the side pieces and the top/bottom pieces. 

\begin{figure}[h]
    \centering
    \begin{subfigure}{0.4\linewidth}
        \centering
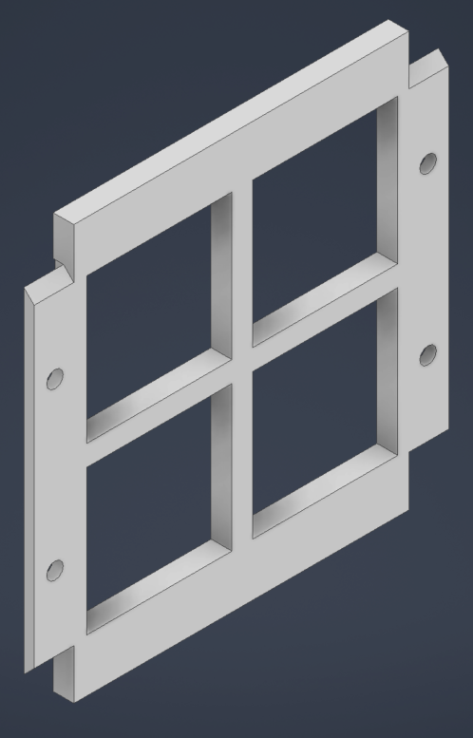
[picture p14: Design/Report/Images/Frame-Side.png]
        
        \caption{Frame side pieces}
        \label{fig:side_piece}
    \end{subfigure}
    \begin{subfigure}{0.4\linewidth}
        \centering
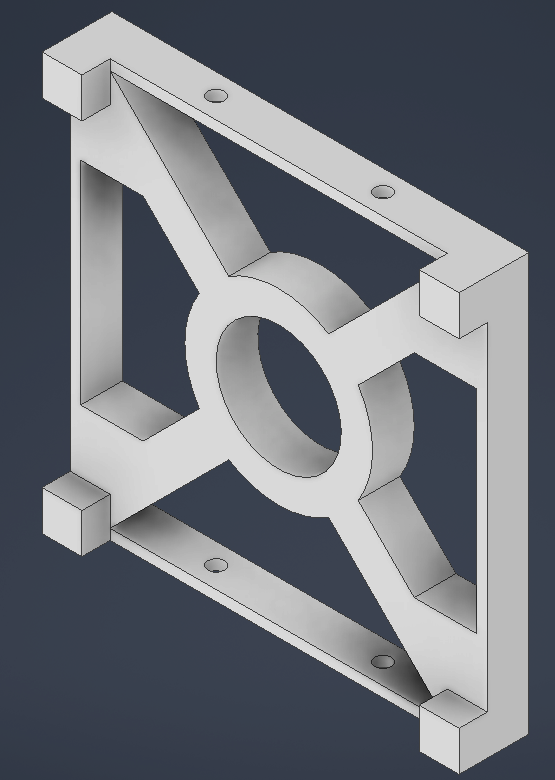
[picture p15: Design/Report/Images/Frame-Top-Bottom.png]
        
        \caption{Top/Bottom piece}
        \label{fig:top_bottom_piece}
    \end{subfigure}
    \caption{Connecting pieces for the ORBITS frame}
    \label{fig:frame_pieces}
\end{figure}

To construct a frame for the ORBITS unit, 2 side pieces and 2 top/bottom pieces are needed. The side pieces are used to connect the top and bottom pieces together to create the frame for the ORBITS unit. By designing the frame in this way allows for the system to be easily assembled and disassembled for maintenance, repair and experimentation. The top and bottom pieces are designed to have mounting points for threaded inserts which allows pcbs to be easily attached to the frame. Shown in Figure \ref{fig:frame_assembled} is the assembled frame for the ORBITS unit components. 

\begin{figure}
    \centering
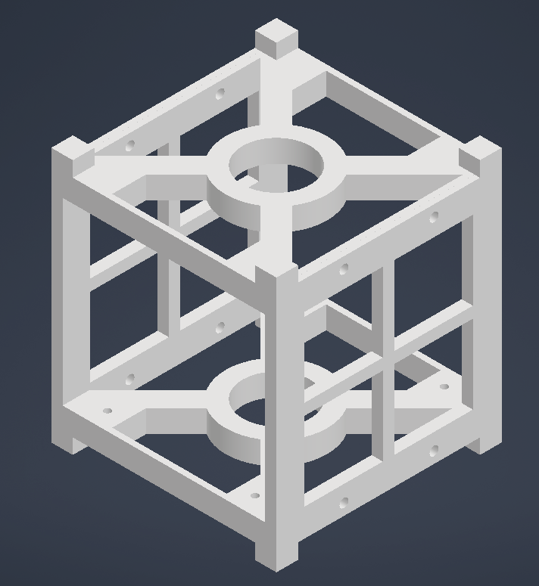
[picture p16: Design/Report/Images/Assembled-Frame.png]
    
    \caption{Assembled frame for the ORBITS unit}
    \label{fig:frame_assembled}
\end{figure}

The frame is designed to be lightweight and simple to manufacture through 3D printing and fits within the 1U CubeSat form factor. The frame is designed to be compact while providing enough space for the required components and leaves room for user defined payloads and provides mounting points for threaded inserts which allows for the 7cm x 9cm PCBs to be simply attached to the frame using brass or nylon standoffs to give each internal layer enough space for the components.

The PCB's within the design are designed to be as repairable as possible. By using through hole components in conjunction to standard pin headers on 2.54mm pitch protoboard, the PCBs are mainly a method to provide the routing connecting between components rather than being a custom designed board with surface mount components. This allows for faulty or damaged components to be easily replaced without the need for specialised equipment or knowledge of soldering.

\subsection{Attitude Determination and Control Subsystem (ADCS)}

The attitude determination and control subsystem (ADCS) is responsible for determining the orientation of the ORBITS unit and providing control to adjust the orientation as needed. This is particularly important for CubeSats as they need to orient themselves to optimise the power gain from the solar panels or provide the required orientation for data collection from the payload. The ADCS subsystem needs to be able to provide accurate attitude determination and control while also being low power and cost effective. 

Rather than implementing a full ADCS system with reaction wheels and magnetorquers, the ORBITS unit looks to focus on the determination aspect of the ADCS subsystem as to reduce the number of components needed within the system and to allow for a more cost effective solution while giving electronics representative to those within a typical CubeSat. The attitude determination can be achieved through the use of an inertial measurement unit (IMU), a type of composite sensor comprised of accelerometers, gyroscopes and magnetometers.

Shown in Table \ref{tab:ADCS-selection-matrix} is the selection matrix for the ADCS IMU.

\begin{table}[h]
    \centering
    \caption{Selection Matrix for ADCS Subsystem}
    \label{tab:ADCS-selection-matrix}
    \begin{tabular}{|p{3cm}|c|c|c|c|c|p{2.5cm}|}
    \hline
    \textbf{Option} & \textbf{Cost} & \textbf{Ecosystem} & \textbf{Performance} & \textbf{Avail.} & \textbf{P/P} & \textbf{Decision} \\ \hline
    \href{https://www.digikey.co.uk/en/products/detail/adafruit-industries-llc/4554/17039173}{Adafruit ICM-20948 Breakout Board}& 5 & 8 & 9 & 7 & 8 & Selected \\\hline
    \href{https://thepihut.com/products/adafruit-lsm6ds3tr-c-6-dof-accel-gyro-imu-stemma-qt-qwiic}{Adafruit LSM6DS3TR Breakout Board}& 4 & 8 & 5 & 8 & 5 & Rejected \\\hline
    \href{https://thepihut.com/products/adafruit-lsm6ds3tr-c-6-dof-accel-gyro-imu-stemma-qt-qwiic}{Adafruit LSM6DSOX Breakout Board}& 5 & 8 & 5 & 8 & 6 & Rejected \\\hline
    \end{tabular}
\end{table}

The IMU chosen for the system was the ICM-20948, a low cost 9-axis IMU. At the price point for the ORBITS system it is typical to find components that aren't as feature dense as more expensive counterparts. In this case, IMU's typically reduce down to 3 or 6 axis variants, with only accelerometers or gyroscopes, for instance the LSM6DS3TR only has 6-axis, 3 for acceleration and 3 for the gyroscope. The ICM-20948, for the same price manages to contain a magnetometer in addition to the accelerometer and gyroscope.

This addition is particularly useful within space applications. Without a magnetometer, the only method that can determine the orientation of the satellite is through the gyroscope. However gyroscopes run into an issue when running for longer periods of time, this being drift. Small uncertainties within the readings build up over time causing the output to be untrustworthy. Unlike the readings from the gyroscope, the magnetometer has an external reference. In the case of typical CubeSats, this is the Earth. By reading the magnetic fields produced by the Earth the sensor is able to calibrate itself relative to North which can be used to correct the drift from the gyroscope and provide a more accurate reading of the orientation of the satellite. 

Shown in Figure~\ref{fig:ICM-20948} is the ICM-20948 IMU.

\begin{figure}[h]
    \centering
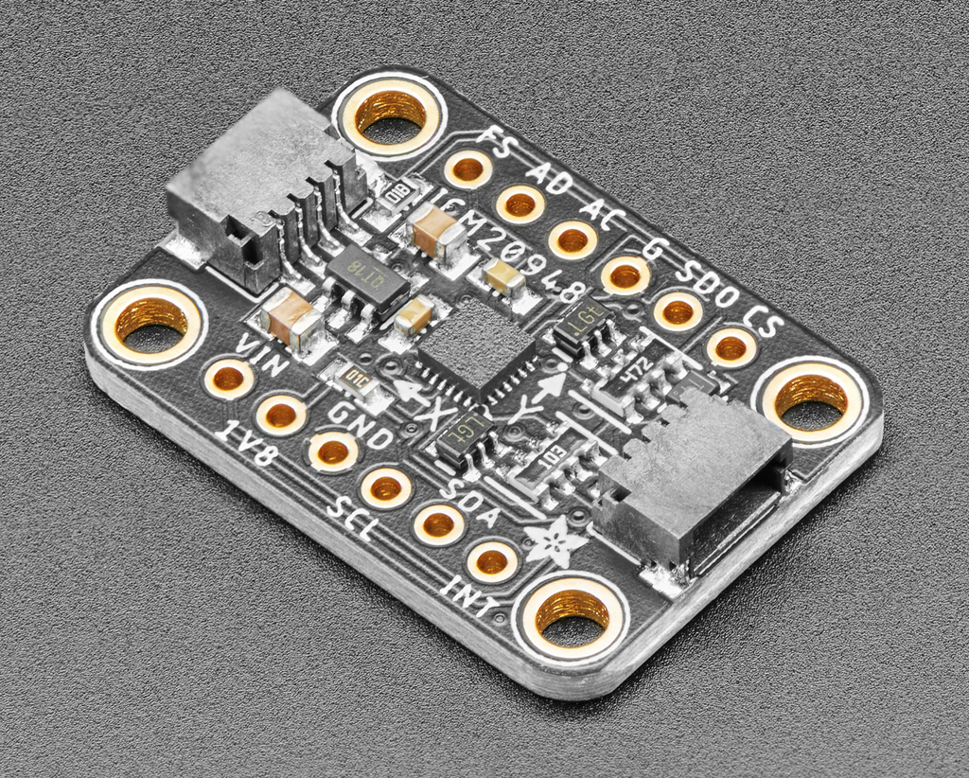
[picture p17: Design/Report/Images/ICM-20948.png]
    
    \caption{Adafruit ICM-20948 9-axis IMU \cite{Adafruit}}
    \label{fig:ICM-20948}
\end{figure}

\begin{itemize}
    \item \textbf{Electrical interface:} 3V to 5V input, with on-board regulator.
    \item \textbf{Data interface:} Both I2C and SPI interface available for communication with the OBC. Configurable I2C address. Conditional interrupt output pin for motion detection and data ready signals.
    \item \textbf{Mechanical interface:}  25.7mm x 17.7mm Adafruit breakout board. Compact size allows for easy integration.
    \item \textbf{Software interface:} Arduino library support with high level functions for reading acceleration, angular velocity and magnetic field data. 
\end{itemize}

\subsection{Payload}

The payload subsystem is responsible for providing the user with the ability to create their own experiments and projects to integrate into the ORBITS unit. Rather than providing a specific payload for the system, the ORBITS unit is designed to be a flexible platform to enable users to create their own payloads.

The rapid prototyping of electronics is already solved through the use of breadboards and perfboards. The payload subsystem provides a top layer development area for users to create their own payloads using a standard 400 pin count breadboard integrated into the top-most layer. This allows for users to create their own circuits and allow for their own creativity to be expressed within the system rather than giving them explicit instructions on how to create a specific payload.

To allow for flexibility and enable creativity, a wide range of communication methods have been made available to use in communicating with the payload. General Purpose Input-Output pins is the most basic category, typically used for wiring up LEDs and transistors but they don't have an explicit purpose. I2C and SPI on the other hand are purpose made communication protocols. I2C focuses on reducing the number of pins required to communicate between a controller device and several peripherals through an address-based system while SPI focuses on providing a high speed communication method between a controller and several peripherals through the use of dedicated pins for each device.

\section{Software Overview} \label{software_design}
The software developed for the ORBITS system can be broken into 2 main components, the software for the ground station and the software for the ORBITS unit. The software for the ground station is responsible for providing a user interface for users to interact with the ORBITS unit and develop their own code while the software for the ORBITS unit is concerned with providing functionality to the components within the stock implementation without any payloads that user defined code integrates into.

%Add general system architecture here with both the ground station software and the orbits unit

\subsection{Ground Station}
%Need to talk about the development of the software on the raspberry pi and add in software structure UML high level architecture probably
The ground station needs to facilitate multiple of the requirements needed for the system to be successful with particular focus on the educational element. The ground station is required to provide the link from a standard laptop or desktop environment to be able to learn about programming within the context of a CubeSat.

The Raspberry Pi Zero 2W is a versatile single board computer that can have a wide range of different applications, in this case acting as the link between the users' development device and the ORBITS unit. With the versatility of such a device a wide range of different approaches can be taken to solve the ground station as many different design methodologies, frameworks and technologies that exist that can come together with differing results.

Commonly, Application Programming Interfaces (APIs) are used as a method for allowing different software components to interact with each other and is used within the ground station to allow for the frontend and backend to communicate with each other but there are several approaches that can be taken to implement an API in a greater tech stack.

%Add in a diagram showing each tech stack approaches
For instance, the MEAN framework (MongoDB, Express.js, Angular and Node.js) is an open source JavaScript framework that is mainly used for cloud based web applications~\cite{MEAN}. This is a highly scalable and flexible framework that can be used to create applications that serve many users at the same time. However, this framework may be overkill for the needs of the ORBITS system as it is designed for larger scale applications and may not be the best fit for a small scale project like this looking to individually serve users from the Raspberry Pi rather than a cloud based application.

In addition, a common tech stack used by hobbyists with the Raspberry Pi ecosystem of devices is LAMP, which stands for Linux, Apache, MySQL and Php or Python~\cite{LAMP}. This is a popular tech stack for web development and can be used to create a web application that serves the needs of the ORBITS system. The LAMP stack can be a good fit for the ORBITS system as it is designed for smaller scale applications and can be easily set up on the Raspberry Pi even with the limited resources available.

Finally, the approach taken for the ORBITS system, a more modern approach to web development is using a Flask backend with a React and AntDesign frontend. This approach allows for a more modern and responsive user interface while still being able to run on the Raspberry Pi. Flask is a lightweight web framework that can be used to create a RESTful API~\cite{REST_API} for the ground station while React or AntDesign can be used to create a user interface that interacts with the API. This approach requires more development time and resources but can provide a better user experience for users interacting with the ORBITS system and can allow the system to be more easily expanded in the future with additional features and functionality.

Shown in Figure~\ref{fig:ground_station_architecture} is the high level architecture for the ORBITS system software.
\begin{figure}[h]
    \centering
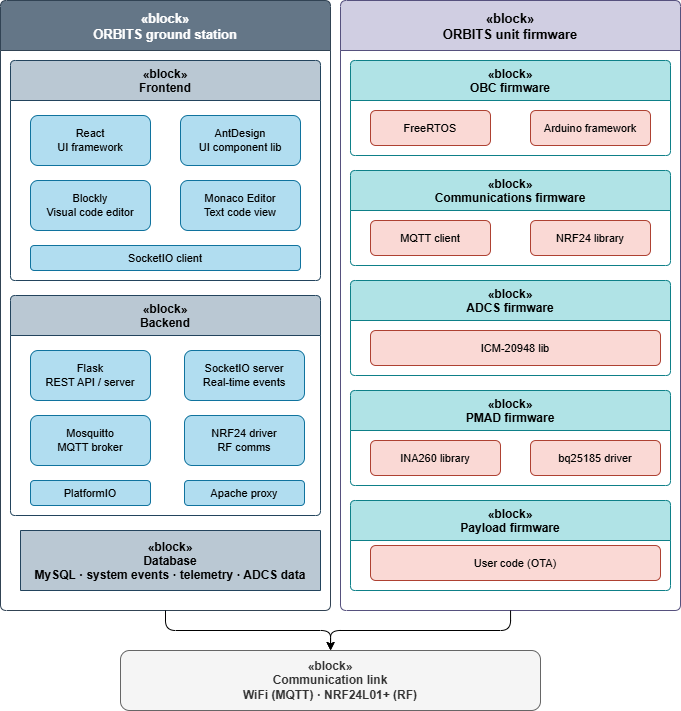
[picture p18: Design/Report/Images/ORBITS_Software.png]
    
    \caption{High level architecture for the ground station software}
    \label{fig:ground_station_architecture}
\end{figure}

\subsubsection{Backend}
%WebSockets, SocketIO, Flask, ground station to unit comms thing you used, apache reverse proxy
%Need to first go into descriptions of each of the technologies used and then go into the architecture of how they all fit together.
The backend architecture for the ground station is built using several components with Flask being the main web framework used to create a RESTful API for the ground station. The reason Flask is used rather than other options like Django or FastAPI because of it simplistic flexibility. It is a lightweight web application framework that enables rapid development and allows for features to be added when needed. The ORBITS dashboard is a simplistic web application with minimal traffic meaning the minimal feature set that a standard flask installation is able to provide all of the functionality required. But this doesn't mean it can't be improved through the added functionality, namely SocketIO.

SocketIO is a library that enables real-time, bidirectional communication between the client and the server. It uses WebSockets as the underlying transport protocol and provides a simple API for handling real-time events. This is particularly useful for the ORBITS system as it allows for real-time updates to the user interface based on events that occur in the backend, such as receiving telemetry data from the ORBITS unit or sending commands to the unit. By using SocketIO, this can allow for more simple development of the frontend as it can listen for events from the backend and update the user interface accordingly without the need for complex polling mechanisms or manual updates.

Similarly to how SocketIO allows for real-time communication between the frontend and backend, Message Queuing Telemetry Transport (MQTT) is used for communications between the ground station and the ORBITS unit. MQTT is a lightweight messaging protocol that is designed for the use in low bandwidth and high latency environments. In this case it is used to connect the two devices through a wireless hotspot created by the ground station. This allows for the ground station to send commands to the ORBITS unit and receive telemetry data back from the unit in real-time, providing a seamless user experience when interacting with the ORBITS system. The use of MQTT requires another service to be running on the Raspberry Pi to handle the MQTT messages, in this case the Mosquitto MQTT broker~\cite{Mosquitto} is used to handle the MQTT messages between the ground station and the ORBITS unit.

In addition to the MQTT broker, to facilitate a communication method more in line with that of a CubeSat, a driver for the NRF24L01+ RF transceiver is included within the backend. This allows for the ground station to communicate with the ORBITS unit through the NRF24L01+ module in addition to the WiFi connection. This provides a more authentic experience for users as they can interact with the ORBITS unit through a method that is more similar to that of a true CubeSat.

By having both the MQTT broker and the NRF24L01+ driver within the backend architecture, this allows for the ground station to have multiple methods of communication with the ORBITS unit. This can provide a more robust and reliable communication system as if one method fails, the other can still be used to communicate with the ORBITS unit. Additionally, this allows for users to choose which method they want to use to communicate with the ORBITS unit, providing more flexibility in how they interact with the system.

In both cases of the MQTT broker and the NRF24L01+ driver, a message protocol needs to be defined to allow for the communication between the ground station and the ORBITS unit to be structured and organised. ArduinoJson is a library that allows for the serialization and deserialization of JSON data in Arduino compatible microcontrollers. This is used to create a message protocol based on the database schema for the telemetry data and system events. This allows for the messages sent between the ground station and the ORBITS unit to be structured in a way that can be easily parsed and stored in the database, providing a seamless integration between the communication methods and the database.

Another major component of the backend architecture is the use of PlatformIO, an open source embedded software development platform that can be run from the command line. This is used to compile and upload the user defined code for the payload to the OBC microcontroller on the ORBITS unit through a feature called Over The Air (OTA) updates, which allows for the code to be uploaded wirelessly through the WiFi connection between the ground station and the ORBITS unit. This allows for users to easily upload their code to the ORBITS unit without needing to physically connect to the device, providing a more seamless user experience when developing their own payloads for the ORBITS system. An alternative to this would be to use the Arduino CLI which provides similar functionality but is not as fully featured as PlatformIO and may require more manual configuration to get working with the ORBITS system including the need to set up an OTA update mechanism manually rather than having it built into the platform.

%Diagram showing more detailed architecture of the backend and how each of the components fit together. ibd diagram.

\subsubsection{Frontend}
%SocketIO, AntDesign, Blockly, Monaco Editor, React 
The frontend architecture for the ground station is built using React as the main framework for building the user interface. React provides a component-based architecture that allows for the creation of reusable UI components, making it easier to manage the complexity of the user interface. In addition to React, several libraries and frameworks are used to enhance the functionality of the frontend.

AntDesign is one such React UI library that provides a wide range of pre-built components and styles. It allows for the creation of a modern responsive user interface with simple extensibility. It allows for the rapid prototyping of the user interface to allow for more iterative development to occur. But this is mainly to provide a better user experience for users interacting with the ORBITS system. Without an engaging and intuitive user interface, users may not be as inclined to interact with the system and potentially not reach the intended learning outcomes. 

For the education programming of the ORBITS system this is also an important factor. Without an engaging and intuitive development environment users may find it difficult to actively learn about the concepts. To make the system as intuitive as possible, Blockly \cite{Blockly} is used to provide a block based development environment for users to create their own code to interact with the ORBITS unit. Blockly allows for users to create code by dragging and dropping blocks that represent different pre-defined programming elements. This can be particularly useful for users who are new to programming or prefer a visual approach to coding. However Blockly is only the visual programming environment and doesn't provide a way for users to see the code being generated by the blocks. To bridge this gap, the Monaco Editor is used to provide a code editor that displays the code being generated by the Blockly editor. This allows users to see the code being generated by the blocks in a text format that can be used for debugging and to bridge the gap between the visual programming and traditional text based programming. Shown in Figure~\ref{fig:blockly_monaco} is the Blockly visual programming environment with the Monaco code editor displaying the generated code.

As this is an educational system, it is important to provide users with the ability to perform some form of analysis on the telemetry data received from the ORBITS unit. This allows users to gain insights into the performance of their payloads and understand how different components of the system interact with each other. Two methods are used to provide this functionality, the first being through the use of ChartJs, a JavaScript library that allows for the creation of interactive charts and graphs. This is used during runtime of an ORBITS unit mission to provide real-time visualisation of the telemetry data being received from the unit. The other method is through allowing the export of the telemetry data in a CSV format that can be used for offline analysis. This allows users to perform more in depth analysis on the telemetry data using tools like Excel or Python, providing a more comprehensive learning experience when interacting with the ORBITS system.

\begin{figure}[h]
    \centering
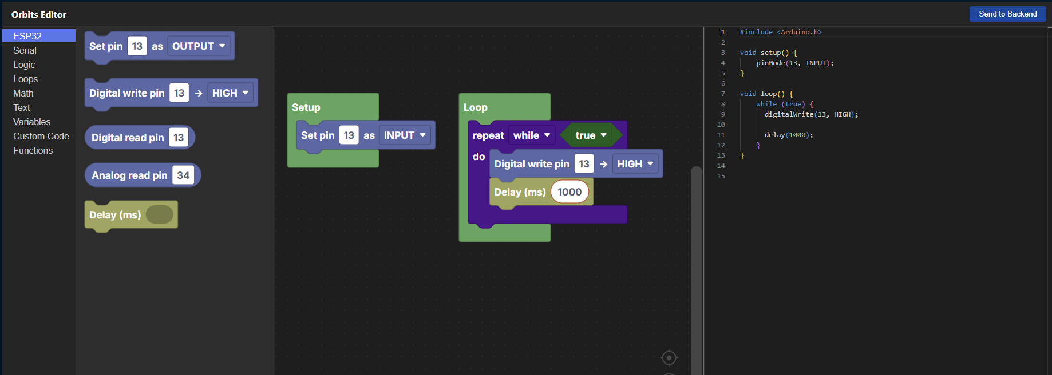
[picture p19: Design/Report/Images/Blockly-Monaco.png]
    
    \caption{Blockly visual programming environment with Monaco code editor}
    \label{fig:blockly_monaco}
\end{figure}

However, a standard Blockly implementation has one problem when it comes to the development of the ORBITS system, and that is the non-deterministic nature of the code generation. The blocks in Blockly can be arranged in any order causing the generated code to be different for the same blocks arranged in a different way.

%Add figure showing the same blocks arranged in different ways generating different code.

This is particularly problematic as the generated code is in C++, as function calls need to be defined before they are called. To solve this problem, a custom code generator is implemented for the Blockly editor that generates the code in a deterministic way regardless of the arrangement of the blocks. 

The user is given 4 standard blocks to create their code, Setup, Loop, Includes and Global Variables, following the standard structure of an Arduino sketch shown in Figure~\ref{fig:arduino_sketch}.
\begin{figure}[h]
    \centering
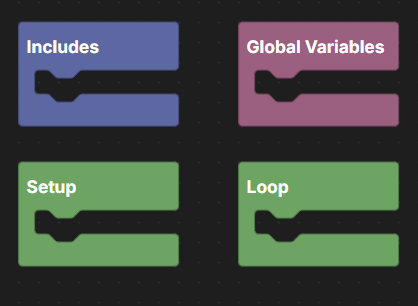
[picture p20: Design/Report/Images/Arduino-Sketch.png]
    
    \caption{Standard structure of an Arduino sketch}
    \label{fig:arduino_sketch}
\end{figure} 

In addition the user is able to define their own functions using Blockly and the custom code generator ensures that these functions are defined before they are called in the generated code. This allows for users to create more complex code for their payloads while still being able to use the visual programming environment provided by Blockly, helping expand the depth of educational material that can be covered through the ORBITS system.

\subsubsection{Database}
%Mimicking actual telemetry data from the ISS mainly from formatting and include schema for the database and phpmyadmin. 
The database within the ground station is used to store general system operations and telemetry from the ORBITS unit, rather than storing it on-board. The database contains 3 separate tables:
\begin{itemize}
    \item \textbf{System Events:} General operations of the device, for instance changing operating mode, charging state or error.
    \item \textbf{Telemetry Updates:} Recurring data coming from the onboard sensors, Not as frequent as that of the ADCS. For instance, voltage and current draw or Payload readings.
    \item \textbf{ADCS Data:} Used to store frequent readings from the Attitude Determination and Control system 
\end{itemize}

These tables follow a similar structure to that of the telemetry data from the ISS. A subset of this data is available through both the ISS Mimic~\cite{ISS-Mimic} project and \href{https://lightstreamer.com/}{Lightstreamer}, and this informed the design of the database schema for the ORBITS system to provide a better analogue to the data that would be received from a real CubeSat. 

The system events tables is structured as such:
\begin{itemize}
    \item \textbf{ID:} Standard automatic incrementing integer primary key.
    \item \textbf{Mission ID:} Unique Identifier to distinguish user variants with different code implementations within the structure.
    \item \textbf{Event Type:} General category in which an operation has occurred like payload operation.
    \item \textbf{Description:} Short description of the operation occurred.
    \item \textbf{Timestamp:} Time at which the operation occurred from on-board real-time clock.
\end{itemize}

The telemetry updates table is structured as such:
\begin{itemize}
    \item \textbf{ID:} Standard auto increment primary key.
    \item \textbf{Mission ID:} Unique Identifier to distinguish different code implementations.
    \item \textbf{Voltage:} The voltage of the system at a given time.
    \item \textbf{Current:} The current draw of the system at a given time.
    \item \textbf{Power:} The power consumption of the system at a given time.
    \item \textbf{Timestamp:} The corresponding time measured by the on-board real-time clock.
\end{itemize}

Finally, the ADCS updates has its own table structured differently. This is to service high request volumes in comparison to the other tables.

\begin{itemize}
    \item \textbf{ID:} Standard auto increment primary key.
    \item \textbf{Mission ID:} Unique Identifier to distinguish different code implementations.
    \item \textbf{Acceleration:} 3 components each corresponding to the acceleration in each axis.
    \item \textbf{Gyroscope:} 3 components representing the Roll, Pitch, and Yaw of the ORBITS unit at a given time.
    \item \textbf{Magnetometer:} 3 components representing the magnetic field strength in each of the 3 axis.
    \item \textbf{Timestamp:} The corresponding time measured by the on-board real-time clock.
\end{itemize}

\subsection{ORBITS Unit Firmware}
%Using standard libraries for the components to make development as simple as possible.
The base software used for the ORBITS unit provides the necessary functionality to operate the components within the system and provide a platform for users to integrate their own code for their payloads. After the user has created their own code for their payload, the code is sent to the ground station for compiling using the PlatformIO and wirelessly transmitted to the ORBITS unit through the WiFi connection. The code is then flashed onto the OBC microcontroller and can subsequently be executed on launch of the ORBITS unit. 

The ESP-32 microcontroller uses the FreeRTOS real-time operating system (RTOS) to manage the different tasks and processes running on the device, for instance the getting the telemetry data from the sensors on the I2C bus and providing them to the MQTT broker. This allows for the efficient use of resources and provides a more responsive experience when interacting with the ORBITS unit. The RTOS allows for the scheduling of tasks and provides mechanisms for inter-task communication, allowing for the different components within the system to work together seamlessly.

In conjunction with the FreeRTOS the software within the ORBITS unit makes use of the Arduino framework and libraries for the components used within the system. This allows for a more user friendly experience as users can make use of the existing documentation and learning materials for these components when creating their own payloads. The software is structured in a way to allow for easy integration of user defined code for payloads while still providing the necessary functionality to operate the system.

Each of the components within the system, if available, have an open source library available for the Arduino framework which allows for a more straightforward development process. For instance, the ICM-20948 IMU has a library provided by Adafruit that allows for easy access to the sensor data and configuration of the sensor. This allows for users to easily integrate the sensor data into their payloads without needing to worry about the low level details of how to communicate with the sensor. Shown in Table~\ref{tab:libraries} is a summary of the libraries used for each of the components within the ORBITS unit.

\begin{table}[h]
\centering
\caption{Summary of libraries used for ORBITS unit firmware}
\label{tab:libraries}
\begin{tabular}{|p{3cm}|p{5cm}|p{8cm}|}
\hline
\textbf{Component} & \textbf{Library} & \textbf{Description} \\ \hline
ICM-20948 IMU & Adafruit ICM-20948 Library~\cite{Adafruit-ICM20X} & Provides functions for reading acceleration, angular velocity and magnetic field data from the ICM-20948 sensor. \\ \hline
INA260 Power Monitor & Adafruit INA260 Library~\cite{Adafruit-INA260} & Provides functions for reading current, voltage and power measurements from the INA260 sensor. \\ \hline
NRF24L01+ RF Transceiver & nRF24 RF24 Library~\cite{nrf24-RF24} & Provides functions for communicating with the NRF24L01+ module, allowing for wireless communication between the ORBITS unit and the ground station without the use of WiFi. \\ \hline
PCF8523 Real-Time Clock & Adafruit PCF8523 Library~\cite{Adafruit-PCF8523} & Provides functions for reading and setting the time on the PCF8523 real-time clock, allowing for accurate timestamping of telemetry data and system events. \\ \hline
BQ25185 Power Management IC & No Official Library & The BQ25185 does not have an official library available, but several pins on the board are available for reading the charging state and any faults that may occur during charging. These pins can be read using standard GPIO functions within the Arduino framework to provide information about the charging state of the ORBITS unit. \\ \hline
\end{tabular}
\end{table}

To allow for the integration of the user defined code for the payloads, a standard structure is defined for the user code to follow. This structure is based on the standard Arduino sketch structure with a setup function and a loop function and this is shown in Figure~\ref{fig:Example_Basic_Sketch}.

\begin{figure}[h]
    \centering
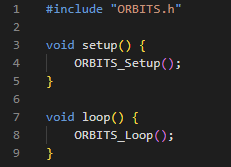
[picture p21: Design/Report/Images/Basic_Sketch.png]
    
    \caption{Standard structure of an ORBITS Arduino sketch}
    \label{fig:Example_Basic_Sketch}
\end{figure}

These functions are used as the entry point for the ORBITS unit firmware and initialise the internal components of the system and run the main loop of the program respectively. The user defined code for the payloads can then be added after these function calls to allow for the user code to run alongside the base software for the ORBITS unit. This allows for users to easily integrate their own code for their payloads while still being able to make use of the existing functionality provided by the base software, providing a seamless integration between the user defined code and the base software for the ORBITS unit.

Within the ORBITS\_setup function the internal and external communications are set up, for instance the I2C bus for the sensors and the WiFi connection for the MQTT broker. This allows for the necessary communication channels to be established. The ORBITS\_loop function is responsible for reading the sensor data from the ICM-20948 IMU and the INA260 power monitor and sending this data to the MQTT broker to be stored in the database and visualised on the dashboard. This allows for the telemetry data from the ORBITS unit to be sent to the ground station in real-time, providing a seamless user experience when interacting with the ORBITS system.

For the telemetry data to be sent to the ground station, the data is read from the sensors and then formatted into a JSON object using the ArduinoJson library. This allows for the data to be structured in a way that can be easily parsed and stored in the database on the ground station. The JSON object is then sent to the MQTT broker through the WiFi connection and subsequently handled by the backend. 

\chapter{Prototype Implementation and Integration}

To ensure the successful implementation of the ORBITS system, a prototype of the system was developed to test the different components and their integration. The prototype was developed using the same components as the final design of the ORBITS unit and ground station, allowing for a more accurate representation of the final system.

\section{Prototype}

The prototype of the ORBITS system was split into three stackable layers to allow for the hardware to fit within the 1U CubeSat. The first layer contains the PMAD and the battery, the second layer contains the OBC, sensors for the ADCS subsystem and communications module while the third layer contains the breadboard for the payload development. This allows for a compact and efficient design that can fit within the constraints of a 1U CubeSat while still providing all of the necessary functionality for the ORBITS system. The layers make use of stackable headers to allow for easy integration and disassembly of the various layers, providing a more modular design that can be modified and expanded upon in future revisions.

Shown in Figure~\ref{fig:prototype-power}, \ref{fig:prototype-OBC} and \ref{fig:prototype-Payload} are each respective layer of the ORBITS prototype.

\begin{figure}[h]
    \centering
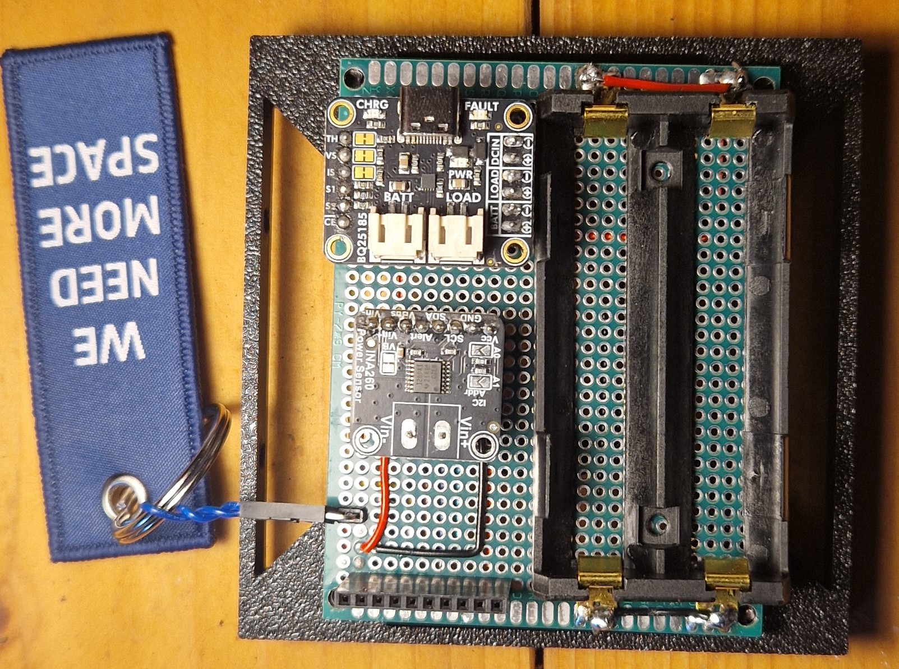
[picture p22: Design/Report/Images/Power-Board.jpg]
    
    \caption{First layer of the ORBITS prototype containing the PMAD and battery}
    \label{fig:prototype-power}
\end{figure}

\begin{figure}[h]
    \centering
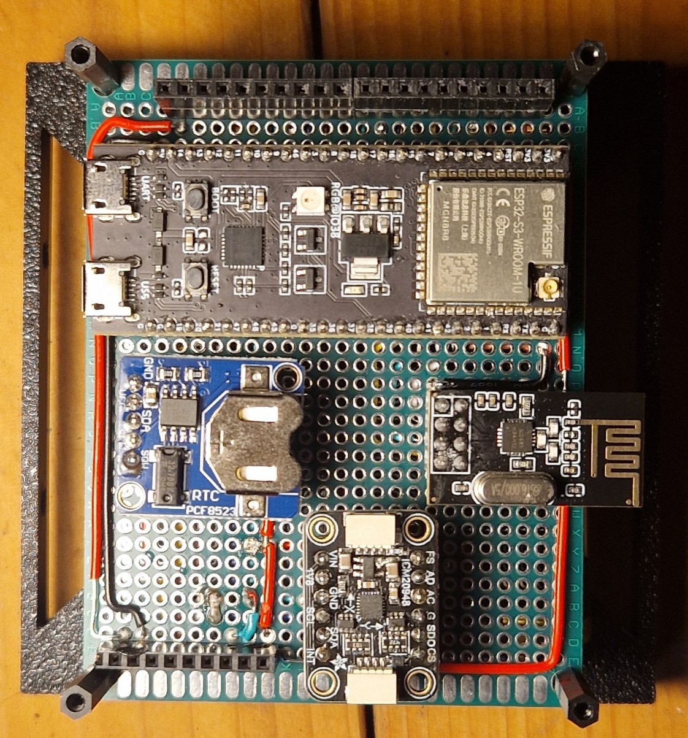
[picture p23: Design/Report/Images/OBC-Board.jpg]
    
    \caption{Second layer of the ORBITS prototype containing the OBC, ADCS sensor and communications module}
    \label{fig:prototype-OBC}
\end{figure}

\begin{figure}[h]
    \centering
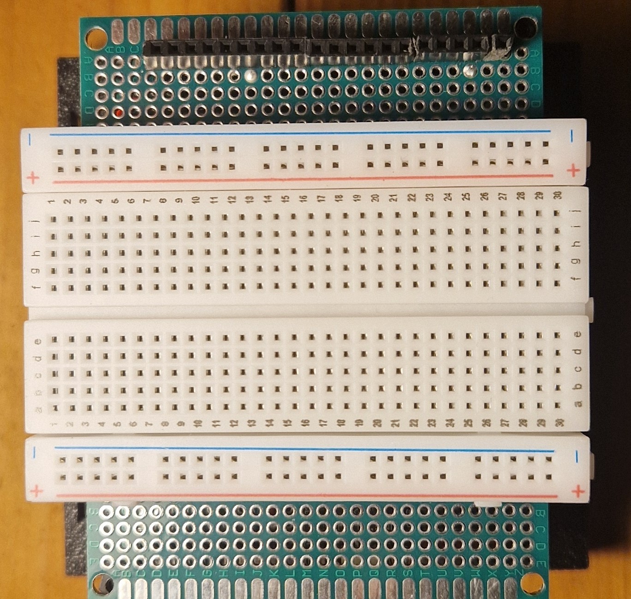
[picture p24: Design/Report/Images/Payload-Board.jpg]
    
    \caption{Third layer of the ORBITS prototype containing the development payload}
    \label{fig:prototype-Payload}
\end{figure}

The process for constructing the prototype involved several steps, beginning with placement of the components on the respective layers and routing the necessary connections between the components. Particular focus was placed on ensuring that the components of the first two layers were entirely routed to a single physical side of the OBC to allow for the stackable header to the payload layer to have full access to seventeen GPIO pins for users to integrate into their payloads.

To ensure the system was functional, the system was first tested in parts, with the PMAD being tested first to ensure that the power management system was able to provide the necessary power to the system. As this board has its own diagnostic LEDs, this made it easier to test the functionality of the board and ensure that no internal fault were occurring during the charging process. 

After the PMAD was validated to be working, the OBC was introduced to the system. A simple sketch was uploaded to the OBC to used to cycle the onboard multicolour LED to provide a visual indication that the OBC was able to successfully receive and execute code, while being powered by the PMAD. 

To validate the functionality of the sensors introduced into the system with the OBC, a simple sketch was uploaded to validate that each of the sensors are discoverable on the I2C bus and that the data being read from the sensors is within expected ranges. Additionally, the unit was assembled to connect all of the components together, which is shown in Figure~\ref{fig:prototype-assembled}. This allowed for the testing of the communication between the OBC and the sensors allowing them to be tested in a more integrated way rather than testing each component in isolation.

\begin{figure}[h]
    \centering
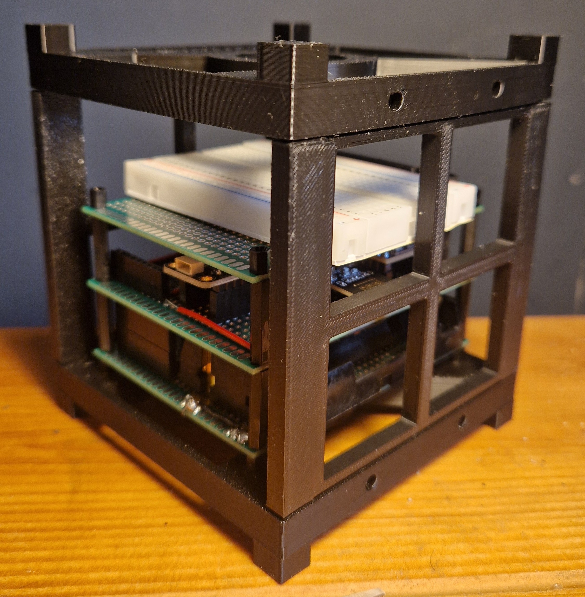
[picture p25: Design/Report/Images/Assembled-Unit.jpg]
    
    \caption{Assembled ORBITS prototype}
    \label{fig:prototype-assembled}
\end{figure}

Shown in Table~\ref{tab:adcs_test} is the data read from the ICM-20948 IMU during testing of the ADCS subsystem while stationary. The data shows that the sensor is able to read the acceleration, angular velocity and magnetic field strength in each of the three axes, providing the necessary data for the attitude determination aspect of the ADCS subsystem.
\begin{table}[h]
\centering
\caption{Data read from the ICM-20948 IMU during testing of the ADCS subsystem}
\begin{tabular}{|c|c|c|c|}
\hline
\textbf{Parameter} & \textbf{Axis} & \textbf{Value} & \textbf{Unit} \\ \hline
Acceleration & X & -0.05 & \(m/s^2\) \\
               & Y & -0.32 & \(m/s^2\) \\
               & Z & 10.00 & \(m/s^2\) \\ \hline
Angular Velocity & X & 0.03 & \(rad/s\) \\
                    & Y & 0.02 & \(rad/s\) \\
                    & Z & 0.01 & \(rad/s\) \\ \hline
Magnetic Field Strength & X & 3.6 & $\mu$T \\
                           & Y & -30.5 & $\mu$T \\
                           & Z & 28.4 & $\mu$T \\ \hline
\end{tabular}
\label{tab:adcs_test}
\end{table}

Along with the ADCS subsystem, the INA260 power monitor was also tested during the prototype phase. The value generated by the INA260 power monitor during the conducted testing is shown in Table~\ref{tab:ina260_test}. The data shows that the sensor is able to read the voltage, current and power consumption of the system, however this data is not within expected ranges. Both the current and power readings are unreliable during this test due to the fact that the system was being powered through the USB connection on the OBC rather than through the PMAD. The reason for this was to use a reliable serial connection to read the data from the sensor rather than introducing the wireless communication methods into the system at this stage of testing. This caused the sensor to be reverse biased as the current was flowing in the reverse direction through the sensor, causing the negative current reading and the power reading to be zero.

\begin{table}[h]
\centering
\caption{Data read from the INA260 power monitor during testing of the ADCS subsystem}
\begin{tabular}{|c|c|c|c|}
\hline
\textbf{Parameter}& \textbf{Value} & \textbf{Unit} \\ \hline
Voltage &  4.68 & \(V\) \\
Current &  -1.25 & \(mA\) \\
Power &  0 & \(mW\) \\ \hline
\end{tabular}
\label{tab:ina260_test}
\end{table}

A corrected test for this system would be to integrate the communications subsystem allowing for the data to be read from the sensor and sent to the ground station database while the system is being powered through the PMAD. This then allows for the current to flow in the correct direction through the sensor and provide more accurate readings for the current and power consumption of the system. This would allow for a more accurate validation of the functionality of the INA260 power monitor within the ORBITS system.

For the communications subsystem, the NRF24L01+ module was able to be integrated into the OBC layer of the prototype and be verified as integrated into the system over SPI but was not able to be successfully tested for communicating with the ground station. This was due to time constraints in developing the relevant service for the Raspberry Pi to support the NRF24L01+ module. As a result, to ensure that communication was established between the ground station and the ORBITS unit, the WiFi connection was used to send MQTT messages from the ORBITS unit to the ground station and messages were successfully received and stored in the database on the ground station. This limitation with the NRF24L01+ module resulted in the lack of a more authentic communication method for the ORBITS unit, but the successful implementation of the WiFi communication method allowed for the necessary communication between the ground station and the ORBITS unit to be established, allowing for the development of the rest of the system to continue without being blocked by this issue. However, without the NRF24L01+ module being successfully tested, the communication methods for the ORBITS system are limited to that of WiFi, which is not as authentic as the intended RF communication method.

Retrospectively, looking back at the original selection of the NRF24L01+ module, it may have been more beneficial to select a different RF communication module that has better support for the Raspberry Pi. 

The Raspberry Pi Zero 2W implemented as the ground station was able to successfully run the backend and frontend software for the ground station, allowing for the necessary user interface to be established for users to interact with the ORBITS system. However, the current implementation of the ground station software does not have the necessary functionality to communicate with the ORBITS unit through the NRF24L01+ module, which limits the communication methods available for users to interact with the ORBITS unit as addressed previously.

As it stands with the current ground station software, users are able to send their Blockly code to the backend of the ground station but the compilation process through PlatformIO and the subsequent OTA update are not functioning as intended through the use of the frontend, meaning the compilation process currently has to occur manually currently.

Due to the limited resources available on the Raspberry Pi, the compilation process is not ideal for the user experience taking upwards of four minutes. This is also the case when an error occurs during the compilation process. As the error messages are not able to be sent back to the user in a timely manner, it is difficult for users to debug their code and understand what went wrong during the compilation process. This is a major limitation of the current implementation of the ground station software as it significantly impacts the user experience when developing their own payloads for the ORBITS system.

However once the code has been compiled the OTA update process is able to successfully upload the compiled code to the ORBITS unit through the WiFi connection showing that the process for uploading code to the ORBITS unit is functional, albeit not currently through the frontend of the ground station software.

The complete prototype bill of materials is provided in Appendix~\ref{app:prototype_bom}. 

%The setup function is used for any initialization code that needs to be run once at the start of the program, while the loop function is used for any code that needs to be run repeatedly during the execution of the program. By following this structure, users can easily integrate their own code into the ORBITS unit while still being able to make use of the existing functionality provided by the base software. This base software is included through the ORBITS.cpp and ORBITS.h files which are accessed by the ORBITS\_setup and ORBITS\_loop functions that are called within the user defined setup and loop functions. This allows for the base software to run alongside the user defined code for the payloads, providing a seamless integration between the two. an example of this structure can be seen in Figure~\ref{fig:Example_Basic_Sketch}.

\section{Limitations}

While the prototype of the ORBITS system provides a solid foundation for the final design, there are several limitations that were encountered during the development of the prototype. These limitations include:
\begin{itemize}
\item \textbf{Limited RF communications validation (NRF24L01+):}
Although SPI-level integration of the NRF24L01+ module was verified, end-to-end communications between the ORBITS unit and the ground station were not successfully demonstrated within the project timeline. This limits validation of the intended CubeSat-analogue communications path. As a mitigation, WiFi/MQTT was used as the primary operational link to enable continued integration and testing of the wider system
\item \textbf{Power monitoring test configuration constraints:}  
During prototype testing, INA260 measurements were taken while the system was powered via the OBC USB interface rather than the PMAD path. This introduced reverse-bias current flow through the sensing path, resulting in unreliable current and power readings for that test case. Consequently, only partial validation of PMAD-integrated power telemetry was achieved in the reported results.

\item \textbf{Ground station compilation performance on Raspberry Pi Zero 2 W:}  
The onboard compilation workflow is functional but slow, with compile times observed at approximately four minutes in typical cases. This creates a poor iteration cycle for users and increases friction when debugging payload code. The system therefore currently relies on a less responsive development loop than intended for classroom use.

\item \textbf{Frontend-to-build pipeline integration immaturity:}  
While Blockly code transfer to the backend was demonstrated, fully integrated frontend-triggered compilation and OTA deployment was not consistently operational at submission time. In practice, parts of the build process required manual intervention. This reduces the level of automation and ease-of-use expected from the ground station software.

\item \textbf{Prototype-stage validation depth:}  
Subsystem bring-up and functional checks were completed for key components, but extended-duration and stress testing were outside the available project window. As a result, reliability under longer mission-like operation and repeated update cycles has not yet been comprehensively characterized.

\item \textbf{Scope-driven simplification of ADCS capability:}  
The implemented ADCS prototype focuses on attitude determination sensing rather than closed-loop attitude control. This was a deliberate scope decision to prioritize a working educational platform within time and resource constraints. The trade-off is that the current prototype does not yet emulate full ADCS actuation behaviour found in higher-fidelity CubeSat systems. As a result, the learning experience around attitude control is currently limited to theoretical concepts rather than hands-on interaction with control hardware.
\end{itemize}

As it currently stands, the ORBITS system only meets some of the project objectives and requirements, with the limitations outlined being the main factors that contribute to the incomplete nature of the system. However, the successful implementation of the different components within the system and their integration provides a solid foundation for future development to address these limitations and further enhance the ORBITS system to meet all of the project objectives and requirements.

Table~\ref{tab:objective_achievement} summarises whether each objective from Table~\ref{tab:project_objectives} has been achieved at this stage of the project.

\begin{table}[h]
\centering
\caption{Objective Achievement Status}
\label{tab:objective_achievement}
\begin{tabular}{|p{9cm}|c|p{5cm}|}
\hline
\textbf{Project Objective} & \textbf{Achieved}& \textbf{Rationale} \\ \hline
Provide a prototype ORBITS unit composed of Commercial Off the Shelf (COTS) components where possible. & Yes & Both ground station and ORBITS unit constructed of COTS components\\ \hline
Provide pilot demonstrations that shall showcase the functionality and purpose of the satellites that ORBITS has been made to emulate. Use understanding of EE105 learning outcomes to aid in project aims and objectives. & No & As there is not a fully implemented solution, learning material would be extremely limited in scope \\ \hline
Provide ``Base Station'', a way of communicating between a standard electronic device and the ORBITS unit. & Partial & The ground station bridges the gap between the ORBITS unit and the development device but requires further development to \\ \hline
Provide relevant software to reduce the barrier of entry to use the product. & Partial & Blockly can successfully be used to create simple programs for the ORBITS unit but lacks more specific features and blocks \\ \hline
Develop and design both software and hardware architecture for systems and decompose into relevant subsystems. & Yes & The ORBITS system was successfully decomposed down to relevant subsystems\\ \hline
Provide product documentation to allow ease of future work based upon this project. & No & No concrete documentation has been provided at this stage \\ \hline
Provide ``Hot Swappable'' modules each with a payload with functionality related to the space industry. & No & The user defines their own payload rather than using pre-defined hot-swappable modules\\ \hline
Provide additional, more complicated modules to aid in the experimentation of different concepts. & No & Users develop their own payload\\ \hline
Provide a viability study into how a product like this could break out into market, creating a financial incentive for future work. & No & A viable product needs to be made first\\ \hline
\end{tabular}
\end{table}

\newpage
\section{Future Work}

Due to the scope of the project, there are several areas that could be expanded upon in the future to further enhance the ORBITS system as in some areas the design and implementation of the system is focused on providing a minimum viable product to meet the requirements of the project. Some areas that could be expanded upon in the future include:
\begin{itemize}
    \item \textbf{Finalise Initial Requirements:} The initial objectives for the ORBITS system were defined at the beginning of the project, but some of these requirements were not fully met in the current design and implementation of the system. For instance, the pilot learning materials have been omitted from the current design of the system, but this can be developed in the future with revisions of the ORBITS system to provide a more comprehensive learning experience for users interacting with the system.
    \item \textbf{Attitude Control:} The current design of the ORBITS unit focuses on the attitude determination aspect of the ADCS subsystem. In the future, this could be expanded to include attitude control through the use of reaction wheels or magnetorquers to provide a more complete ADCS system.
    \item \textbf{Ground Station Software:} The current design of the ground station software provides a basic user interface for interacting with the ORBITS unit. In the future, this could be expanded to include additional features such as data visualization tools, more advanced telemetry analysis and support for multiple users interacting with the system simultaneously. Additionally the compilation process through the frontend of the ground station software could be optimised to provide a better user experience when developing their own payloads for the ORBITS system.
    \item \textbf{Solar Panels:} The current design of the ORBITS unit includes support for solar charging through the power management module, but does not include actual solar panels. In the future, solar panels could be added to the design to allow for more authentic charging of the ORBITS unit and to provide a more complete experience for users.
    \item \textbf{Improved Dashboard:} The current design of the dashboard provides a basic interface for users to interact with the ORBITS unit and view telemetry data. In the future, the dashboard could also be used as a control interface for users to send commands defined by the user to the ORBITS unit to control the system and interact with their payloads in real-time, providing a more engaging and interactive experience for users.
    \item \textbf{ORBITS Unit Firmware Optimisation:} The current design of the ORBITS unit firmware provides the necessary functionality to operate the system but heavily relies on the use of libraries for the components within the system with possible repeat functionality across the different libraries for instance, the ICM-20948 library and the INA260 library both have some method of reading data from each individual sensor on the I2C bus, while a more general approach can allow each sensor to be addressed and read in a more efficient way, reducing the overhead of the firmware and allowing for more resources to be available for user defined code for payloads.
    \item \textbf{Complete NRF24L01+ OTA:} The current design of the ORBITS unit allows for OTA updates through the WiFi connection but does not currently support OTA updates through the NRF24L01+ module. In the future, this could be implemented to allow for users to upload their code to the ORBITS unit through a more authentic communication method, providing a more complete experience for users.
    \item \textbf{Enhance Educational Programming:} Additional blocks can be added to the Blockly editor to allow for more complex code to be generated for user defined payloads, allowing for a wider range of educational material to be covered through the ORBITS system. For instance, blocks that interact with specific payloads could be added to allow for users to easily integrate new payloads and make it more accessible for users to create their own payloads without needing to worry about the low level details of how to interact with the components within the ORBITS unit.
\end{itemize}

What can also be taken from this project is the potential for future iterations of the ORBITS system. The design and implementation of the current ORBITS system provide a solid foundation that can be further developed to widen the scope of teaching available through the system. For instance, the current design of the ORBITS unit is focused on providing a platform for users to learn about programming within the context of a CubeSat, but future iterations of the system could expand to cover other aspects of CubeSat design and operation such as thermal management or satellite communication systems. This would allow for a more comprehensive learning experience for users and provide a more complete understanding of the different subsystems that make up a CubeSat.

The implementation of the ORBITS system also provides a platform for other emulatory devices to be developed in the future. For instance, keeping within the space theme, a similar system could be developed to emulate the operations of a Mars rover or a lunar lander, as many of the systems constructed for the ORBITS unit could be repurposed for these types of systems. This would allow for a wider range of educational material to be covered with the same underlying principles of providing a platform for users to learn about programming and system design within the context of space exploration.

\section{Reflection}

The ORBITS project has demonstrated that an accessible, low-cost CubeSat emulator can be implemented using a modular architecture and commercial off-the-shelf components. The delivered prototype integrates the core hardware subsystems and a working ground-station software stack, and therefore establishes a credible technical baseline for educational use. At the same time, the objective review in Table~\ref{tab:objective_achievement} shows that this submission is best described as a partial completion of the full project vision, with key gaps remaining in end-to-end RF communications, frontend build/deployment maturity, and breadth of validation.

From an engineering perspective, the most significant lesson from this project was the importance of integration-first development and early risk reduction. Several late-stage issues were not caused by individual subsystem failures, but by interface and workflow constraints between subsystems. This reinforced the value of validating critical pathways earlier, particularly communications and deployment pipelines, while maintaining clear traceability between objectives, implementation decisions, and test evidence.

Overall, the current ORBITS implementation provides a strong foundation for future iterations rather than a finalised educational product. The system is already capable of supporting meaningful learning and experimentation, and the limitations identified in this report define a clear and actionable path to improve usability, technical fidelity, and classroom readiness in subsequent development cycles.

\printbibliography[heading=bibintoc]
\newpage
\appendix
\chapter{Appendices}
\section{GitHub Repository}
As part of the project, a GitHub repository was created to host all of the elements of the project including the design documents, code for the ORBITS unit firmware and ground station software, found here \url{https://github.com/WithASideOfSalt/EE475-ORBITS}
\section{Prototype Bill of Materials}\label{app:prototype_bom}
\begin{landscape}
    \thispagestyle{empty}
    \begin{table}[p]
    \centering
    \caption{Prototype Bill of Materials}
    \setlength{\tabcolsep}{3pt}
    \renewcommand{\arraystretch}{1.0}
    \resizebox{\linewidth}{!}{%
    \begin{tabular}{|l|c|l|l|l|l|r|r|}
    \hline
    \textbf{Item \#} & \textbf{Qty} & \textbf{Category} & \textbf{Manufacturer} & \textbf{Part Number} & \textbf{Description} & \textbf{Unit Price} & \textbf{Sub Total} \\ \hline
    Ground Station.1 & 1 & Ground Station & Raspberry Pi & SC1146 & Raspberry Pi Zero 2 W & \pounds11.26 & \pounds11.26 \\ \hline
    Ground Station.2 & 1 & Ground Station & SOLDERED & 101219 & RF Modules NRF24L01+, MODULE, 2.4GHz, RF & \pounds3.18 & \pounds3.18 \\ \hline
    Ground Station.3 & 1 & Ground Station & University of Strathclyde & 3DRPiHousing & 3D Printed Ground Station housing & \pounds0.11 & \pounds0.11 \\ \hline
    Ground Station.4 & 1 & Ground Station & Cvilux USA & DH-20M50057 & CABLE USB AM TO MICRO 2.0 0.49' & \pounds0.84 & \pounds0.84 \\ \hline
    Ground Station.5 & 1 & Ground Station & SanDisk & SDSQUA4-032G-GN6MA & 32 GB MicroSDHC microSD, UHS Speed Class U1 & \pounds8.32 & \pounds8.32 \\ \hline
    OBC.1 & 1 & OBC & Espressif Systems & ESP32-S3-DevKitC-1U-N8R8 & ESP32-S3-WROOM-1-N8R8 & \pounds9.93 & \pounds9.93 \\ \hline
    OBC.2 & 1 & OBC & Adafruit Industries & 3295 & Adafruit PCF8523 RTC Breakout Board & \pounds5.22 & \pounds5.22 \\ \hline
    OBC.3 & 1 & OBC & Panasonic & CR-1220/BN & Button Battery, 3 V, 12.5 mm Diameter & \pounds1.07 & \pounds1.07 \\ \hline
    PMAD.1 & 1 & PMAD & Adafruit Industries & 6091 & bq25185 USB / DC / Solar Lithium Ion/Polymer charger & \pounds5.22 & \pounds5.22 \\ \hline
    PMAD.2 & 1 & PMAD & RS Pro & 304-24-490 & 3.7 V, Lithium-ion 18.9 mm Rechargeable Battery, 2.6 Ah & \pounds8.19 & \pounds8.19 \\ \hline
    PMAD.3 & 1 & PMAD & Keystone Electronics & 1043P & BATTERY HOLDER 18650 PC PIN & \pounds2.52 & \pounds2.52 \\ \hline
    PMAD.4 & 1 & PMAD & Adafruit Industries & 4226 & Adafruit INA260 High or Low Side Voltage Current Power Sensor & \pounds7.47 & \pounds7.47 \\ \hline
    Comms.1 & 1 & Comms & SOLDERED & 101219 & RF Modules NRF24L01+, MODULE, 2.4GHz, RF & \pounds3.18 & \pounds3.18 \\ \hline
    PS.1 & 2 & PS & University of Strathclyde & 3DFrameType1 & Upper and Lower 3D printed Frame Section & \pounds0.35 & \pounds0.70 \\ \hline
    PS.2 & 2 & PS & University of Strathclyde & 3DFrameType2 & 3D Printed Side frames & \pounds0.24 & \pounds0.48 \\ \hline
    ADCS.1 & 1 & ADCS & Adafruit Industries & 4554 & Adafruit ICM-20948 DOF IMU & \pounds14.95 & \pounds14.95 \\ \hline
    MISC.1 & 1 & MISC & Cvilux USA & DH-20M50054 & USB 2.0 Cable A Male to C Male 0.49' (150.0 mm) Shielded & \pounds0.94 & \pounds0.94 \\ \hline
    MISC.2 & 1 & MISC & The Pi Hut & 105833 & Proto PCB 10-Pack 7x9 cm & \pounds5.70 & \pounds5.70 \\ \hline
    MISC.3 & 4 & MISC & Sin & MSIB-M2-400 & M2 4 mm Threaded Insert & \pounds0.19 & \pounds0.76 \\ \hline
    MISC.4 & 1 & MISC & DRFROBOT & FIT0146 & Stackable Female Pin Header 8 pin x10 & \pounds2.63 & \pounds2.63 \\ \hline
    MISC.5 & 5 & MISC & Harwin & M20-7820542 & Vertical Female Header 10 pin & \pounds0.79 & \pounds3.95 \\ \hline
    MISC.6 & 1 & MISC & The Pi Hut & 100058 & Half Size Breadboard, 400 count & \pounds3.00 & \pounds3.00 \\ \hline
    MISC.7 & 1 & MISC & The Pi Hut & 104335 & M2.5 Nylon Standoff 6 mm Male-Female x10 & \pounds0.70 & \pounds0.70 \\ \hline
    MISC.8 & 1 & MISC & The Pi Hut & 104333 & M2.5 Nylon Standoff 12 mm Male-Female x10 & \pounds0.70 & \pounds0.70 \\ \hline
    \multicolumn{7}{|r|}{\textbf{Total}} & \textbf{\pounds101.02} \\ \hline
    \end{tabular}%
    }
    \end{table}
\end{landscape}

\begin{landscape}
    \includepdf[pages=-, 
    width=1.5\textwidth,
    landscape = true,
    pagecommand={   \section{ORBITS Frame} \label{app:orbits_frame},
                    \thispagestyle{empty} }
  ]{./Appendices/ORBITS-Frame.pdf}
\end{landscape}

\end{document}
