WithASideOfSalt/EE475-ORBITS/Dashboard/src/assets/Isolated.png

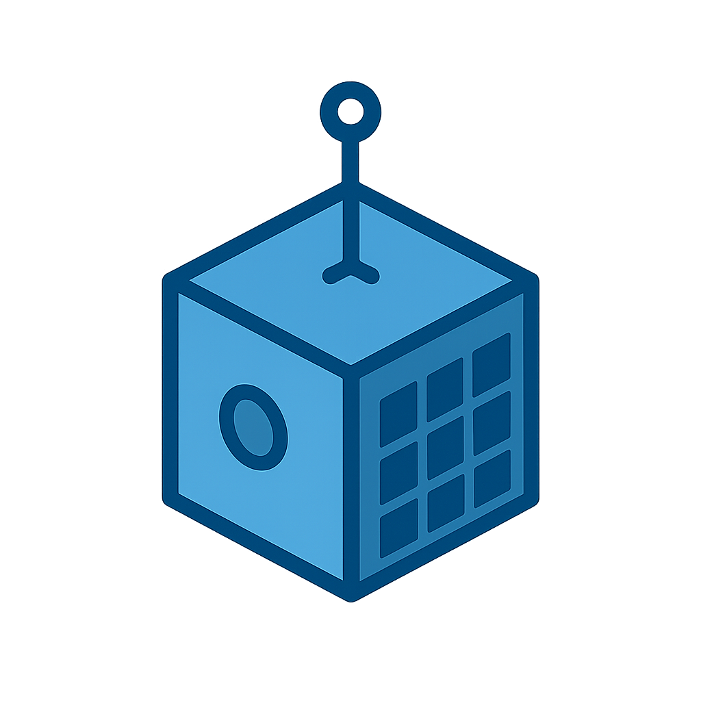
Dashboard/src/assets/Isolated.png
