WithASideOfSalt/EE475-ORBITS/Design/Report/Images/ORBITS_Logical_Boundary.png

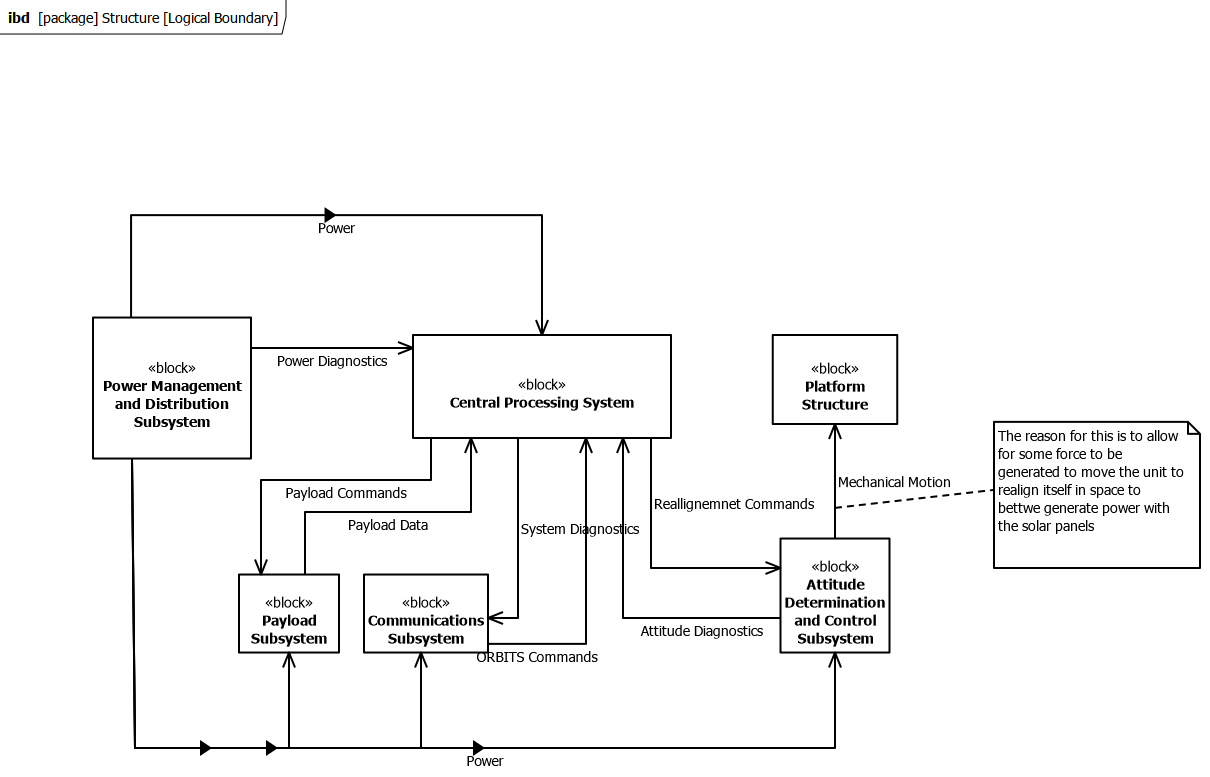
Design/Report/Images/ORBITS_Logical_Boundary.png
