WithASideOfSalt/EE475-ORBITS/Design/Report/Images/ORBITS_Logical_Structure.png

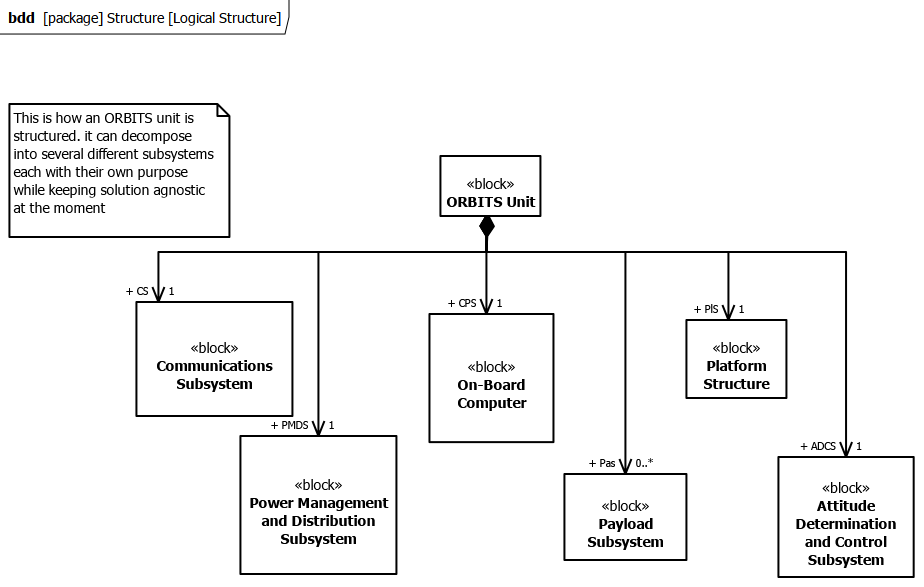
Design/Report/Images/ORBITS_Logical_Structure.png
