WithASideOfSalt/EE475-ORBITS/(list of files, cad)

Other CAD files:
3D Model/ORBITS Frame (mm).dwg
3D Model/ORBITS Frame.iam
3D Model/Side Panel.ipt
3D Model/Top&Bottom.ipt
