WithASideOfSalt/EE475-ORBITS/Design/Report/Appendices/ORBITS-Frame.pdf

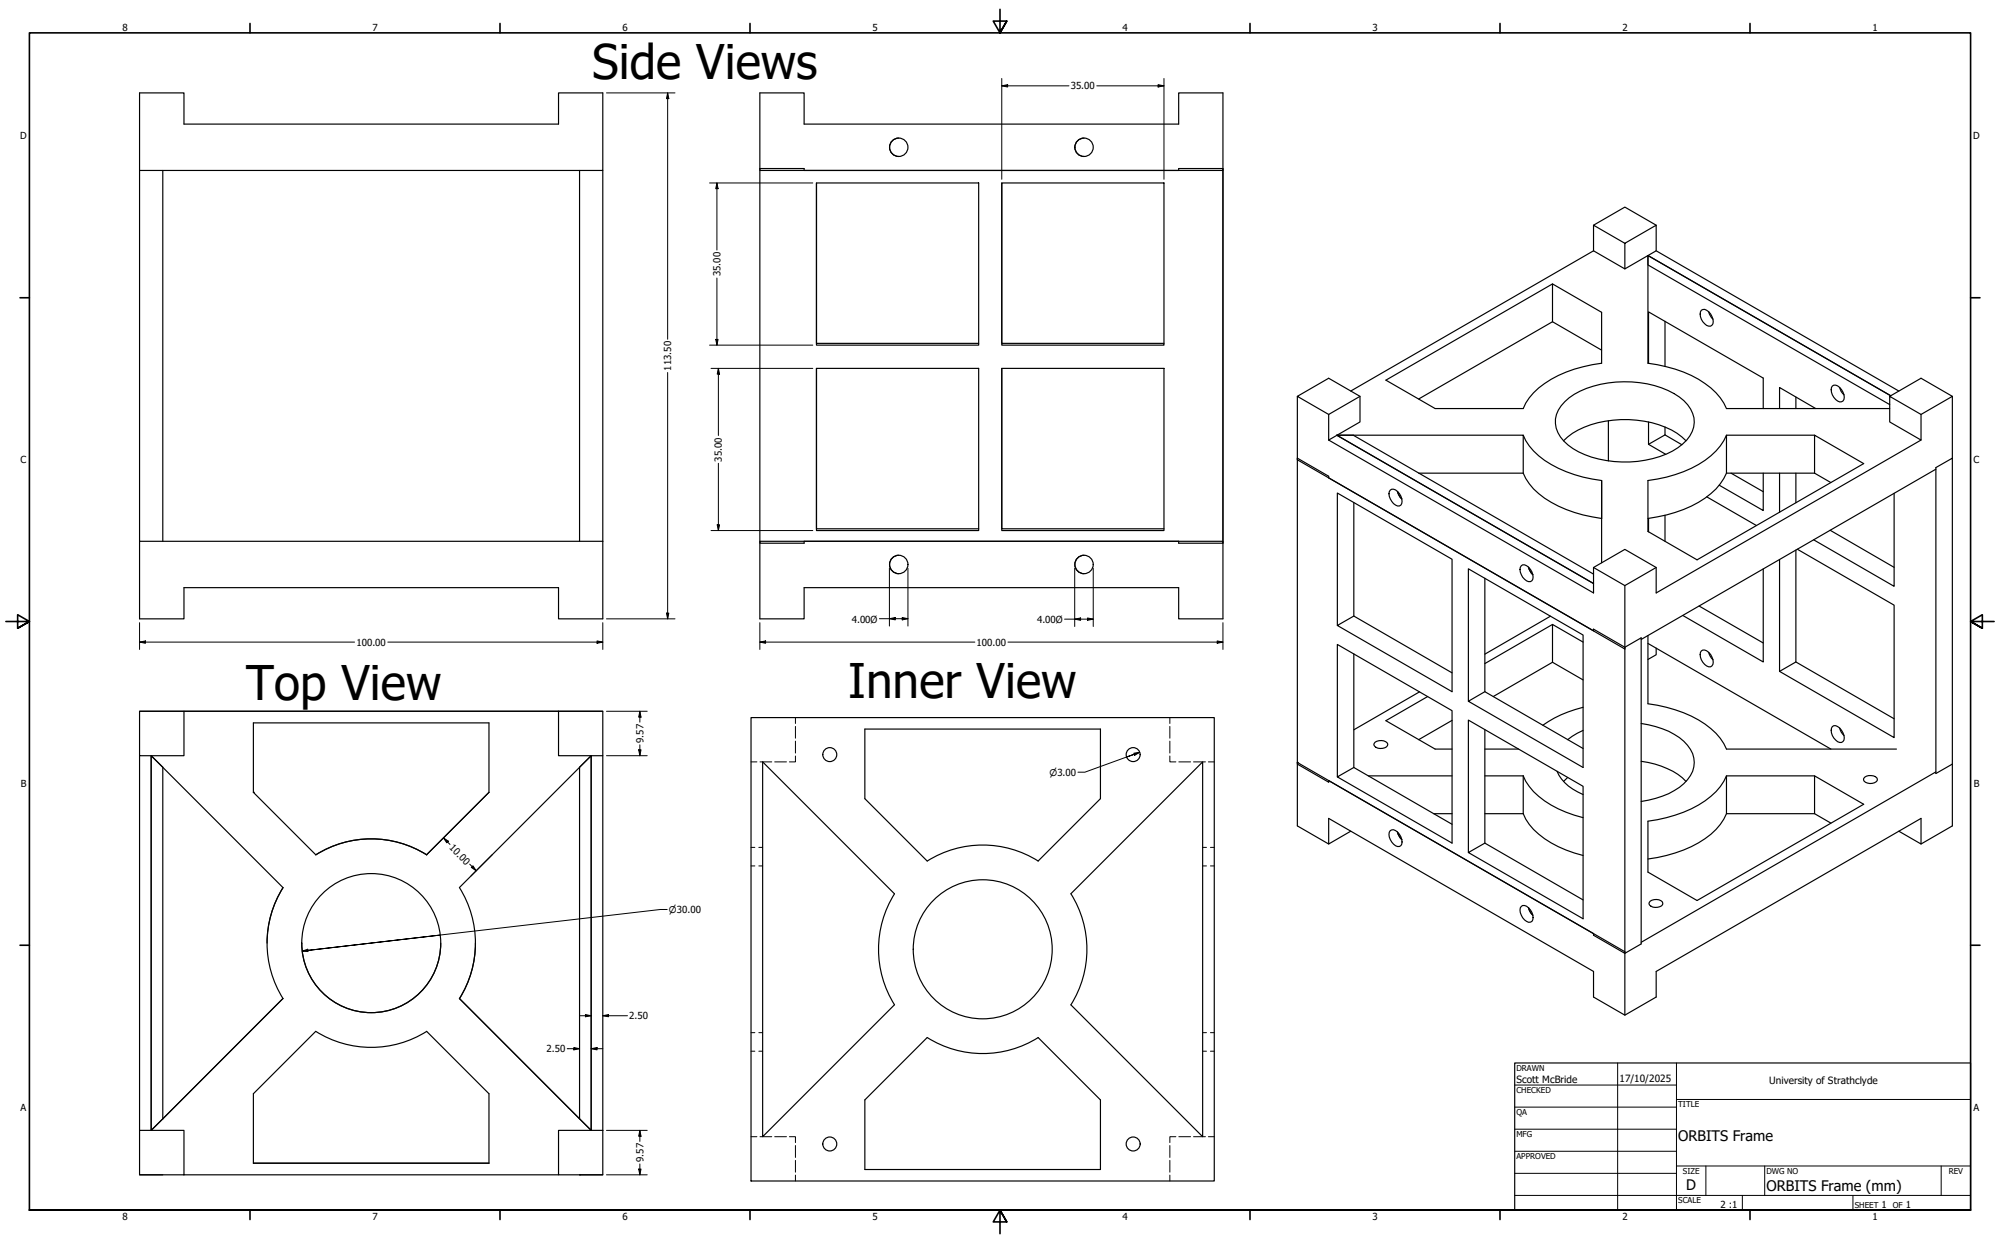
[picture p29: page 1]
ORBITS Frame; Side Views; Top View; Inner View

DRAWN Scott McBride | 17/10/2025 | University of Strathclyde

CHECKED

MFG

APPROVED

SIZE D | DWG NO ORBITS Frame (mm) | REV

SCALE 2 :1 | | SHEET 1 OF 1
