WithASideOfSalt/EE475-ORBITS/Design/Report/Appendices/ORBITS Frame.pdf

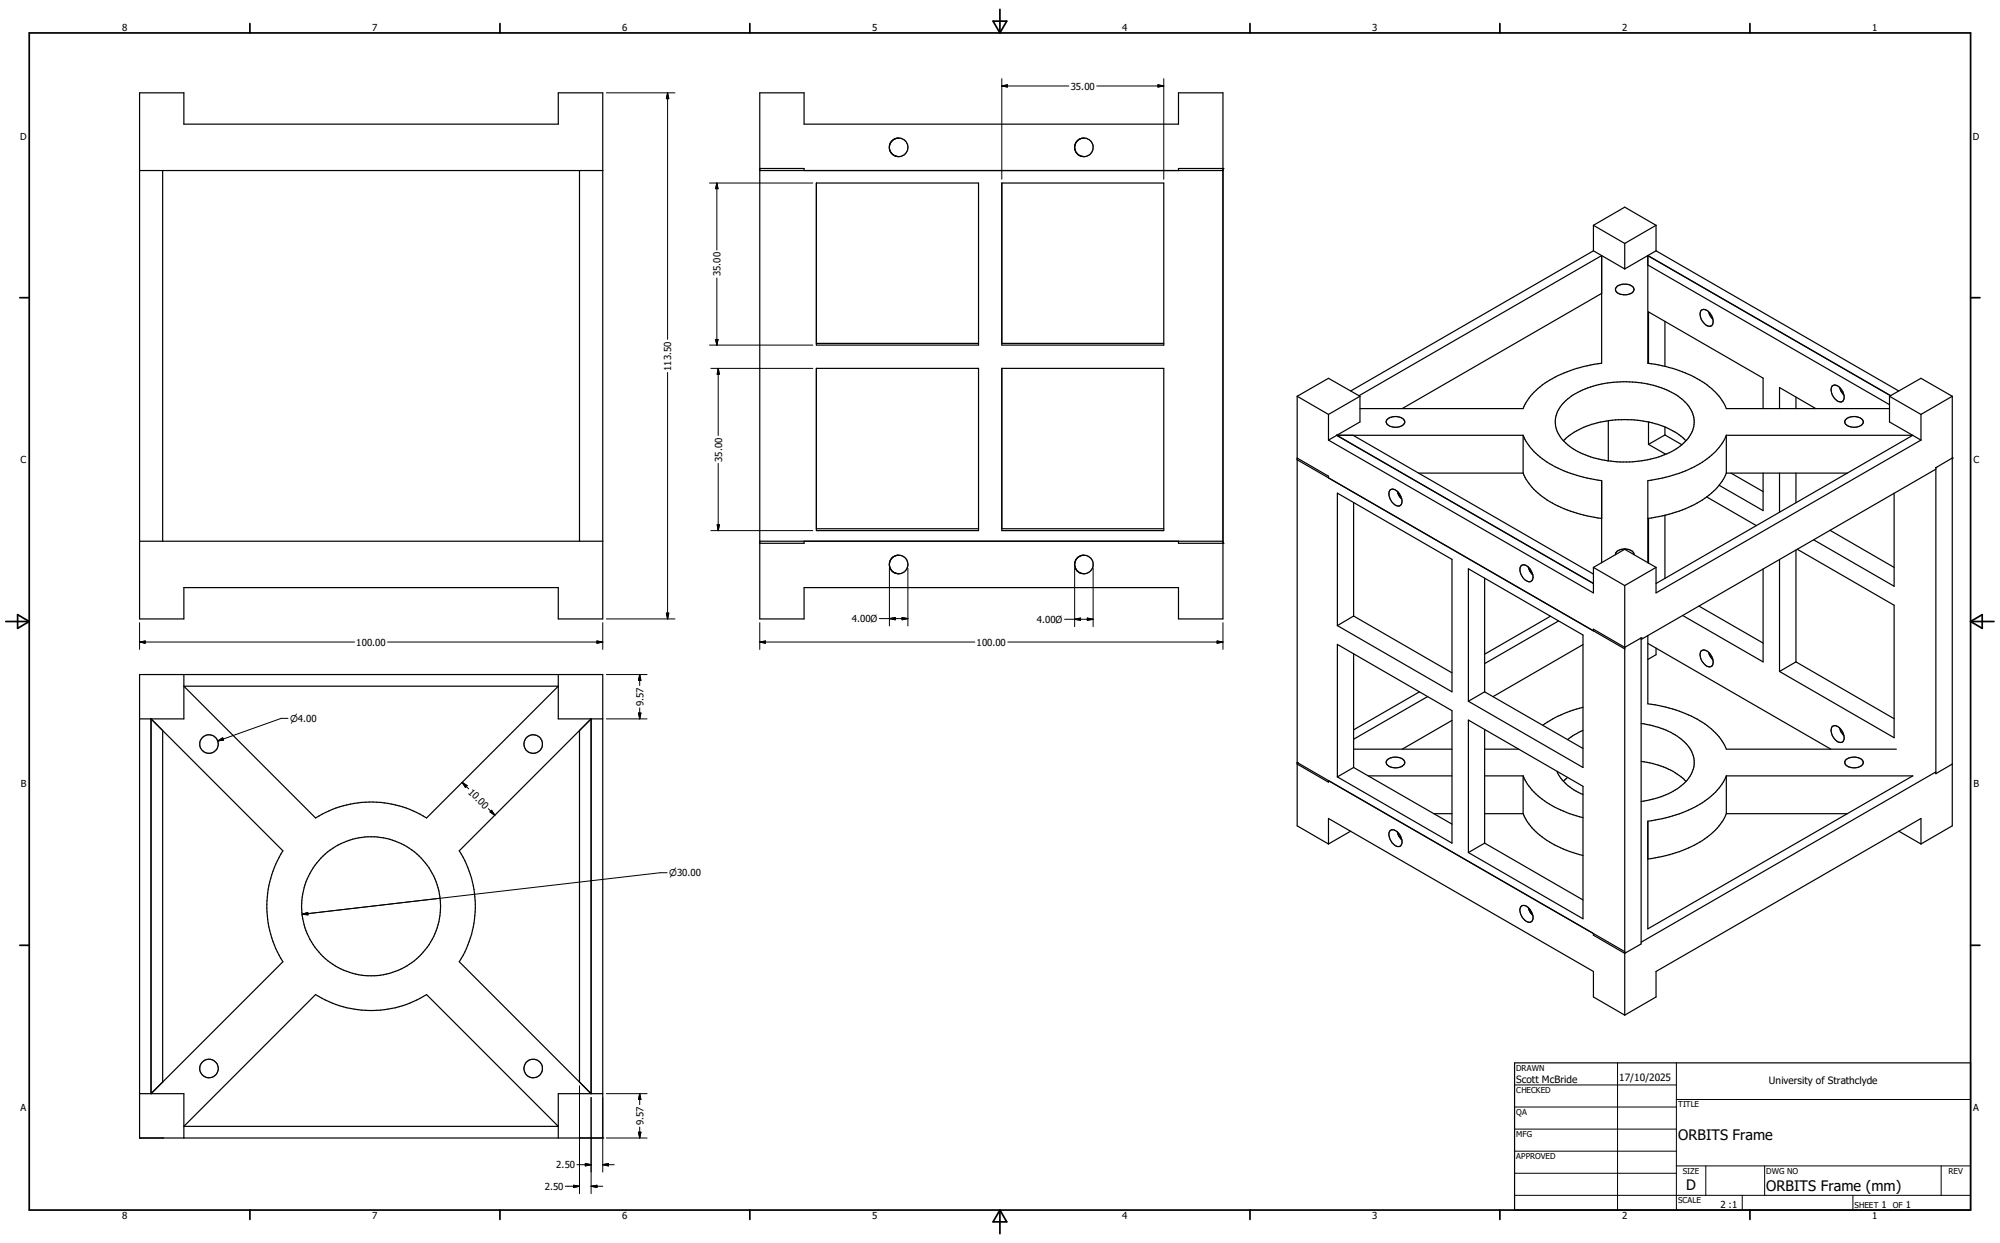
[picture p30: page 1]
TITLE; ORBITS Frame; 2 :1 ¹¹³.50

DRAWN Scott McBride | 17/10/2025 | University of Strathclyde

CHECKED

MFG

APPROVED

SIZE D | | DWG NO ORBITS Frame (mm) | REV

SCALE | | SHEET 1 OF 1
