WithASideOfSalt/EE475-ORBITS/ORBITS/src/ORBITS.cpp

// Basic demo for accelerometer & gyro readings from Adafruit
// LSM6DSOX sensor

#include <Adafruit_ICM20X.h>
#include <Adafruit_ICM20948.h>
#include <PubSubClient.h>
#include <ArduinoJson.h>
#include <WiFi.h>
#include <Adafruit_INA260.h>
#include <Adafruit_NeoPixel.h>
#include <ArduinoOTA.h>
#include <RTClib.h>
#include "RF24.h"
#include "ORBITS.h"

//Internal I2C Bus for sensor communications
TwoWire internalI2CBus = TwoWire(0);
unsigned long lastTime = 0;
unsigned long lastTelemetrySend = 0;

//Wifi and MQTT credentials
WiFiClient espClient;
PubSubClient mqtt(espClient);

//MQTT Function Router, gets pulled from the main code and allows for user defined functions to be called based on the topic of the incoming MQTT message. This allows for more modular code and easier handling of incoming MQTT messages without having to write a large if-else statement in the mqtt_callback function.

MQTTRoute *mqtt_routes;
int NUM_ROUTES;
//Sensors
Adafruit_ICM20948 icm;
Adafruit_INA260 ina260;
RTC_PCF8523 rtc;

//OTA and MQTT timing variables
uint32_t last_ota_time = 0;
unsigned long lastMqttReconnectAttempt = 0;

// LED Pin
Adafruit_NeoPixel ORBITS_strip(1, 38, NEO_GRB + NEO_KHZ800);


void ORBITS_Setup(MQTTRoute *routes, int num_routes) {
  Serial.begin(115200);

  mqtt_routes = routes;
  NUM_ROUTES = num_routes;

  while (!Serial)
    delay(10);  // Makes sure the serial monitor has been configured and ready

  Serial.println("Begin ORBITS initialisation Operations...");

  //Network LED
  pinMode(network_led_pin, OUTPUT);
  digitalWrite(network_led_pin, LOW);

  internalI2CBus.begin(21,47, 100000);

  //Check if sensors are connected and discoverable
  if (!icm.begin_I2C(0x69,&internalI2CBus)) {
      Serial.println("ICM20948 Not Found!");
  }

  if (!ina260.begin(0x40, &internalI2CBus)) {
    Serial.println("INA260 Not Found!");
  }

  if (!rtc.begin(&internalI2CBus)) {
    Serial.println("RTC Not Found!");
  }

  //Configure Wifi and connect to ground station hotspot
  WiFi.mode(WIFI_STA);
  WiFi.setHostname(hostname);
  WiFi.begin(ssid, password);
  Serial.print("Connecting to WiFi...");
  while (WiFi.status() != WL_CONNECTED) {
    delay(250);
    Serial.print(".");
    //WiFi.begin(ssid, password);
  }
  Serial.println();
  ORBITS_strip.begin();
  ORBITS_strip.setPixelColor(0, ORBITS_strip.Color(0, 1, 0));
  ORBITS_strip.show();

  //Display connection info
  Serial.print("\nESP32 IP Address: ");
  Serial.println(WiFi.localIP());
  Serial.print("ESP32 HostName: ");
  Serial.println(WiFi.getHostname());
  Serial.print("RRSI: ");
  Serial.println(WiFi.RSSI());

  mqtt.setServer(mqtt_server, mqtt_port);
  mqtt.setCallback(mqtt_callback);

  //Just Use Default Sensor Settings for now, can be changed as needed
  reconnect_mqtt();

  // ArduinoOTA setup
  ArduinoOTA.setHostname(hostname);
  ArduinoOTA.begin();
  Serial.println("ArduinoOTA ready");
}

void ORBITS_Loop() {
  ArduinoOTA.handle();

  digitalWrite(network_led_pin, WiFi.status() == WL_CONNECTED ? HIGH : LOW);

  if (WiFi.status() == WL_CONNECTED) {
    if (!mqtt.connected() && millis() - lastMqttReconnectAttempt > 2000) {
      lastMqttReconnectAttempt = millis();
      reconnect_mqtt();
    }
    mqtt.loop();
  }

  //get MPU data and send it to the ground station
  unsigned long currentMillis = millis();
  if(currentMillis - lastTime >= 200) {
    lastTime = currentMillis;
    send_imu_data();
  }

  unsigned long currentTelemetryMillis = millis();
  if(currentTelemetryMillis - lastTelemetrySend >= 1000) {
    lastTelemetrySend = currentTelemetryMillis;
    //send other telemetry data such as voltage, current, temperature, etc.
    send_telemetry_data();

  }

}

void reconnect_mqtt(){
  if (!mqtt.connected()) {
    Serial.print("Connecting to MQTT...");
    if (mqtt.connect(hostname)) {
      Serial.println("connected");

      for (int i = 0; i < NUM_ROUTES; i++) {
        mqtt.subscribe(mqtt_routes[i].topic);
        Serial.print("Subscribed to: ");
        Serial.println(mqtt_routes[i].topic);
      }

    } else {
      Serial.print("failed with state ");
      Serial.print(mqtt.state());
      Serial.print("\n");
    }
  }
}

void mqtt_callback(char* topic, byte* payload, unsigned int length) {
    Serial.print("Message arrived on topic: ");
    Serial.println(topic);

    JsonDocument doc;
    DeserializationError error = deserializeJson(doc, payload, length);

    for (int i = 0; i < NUM_ROUTES; i++) {
        if (strcmp(topic, mqtt_routes[i].topic) == 0) {
            if (error) {
                Serial.printf("JSON parse failed for topic %s: %s\n", topic, error.c_str());
                return;
            }
            mqtt_routes[i].handler();
            return;
        }
    }
    Serial.printf("No handler found for topic: %s\n", topic);
}

void send_telemetry_data(){
  // Get telemetry data from ICM + INA260 and send it to the ground station.
  JsonDocument doc;

  sensors_event_t accel;
  sensors_event_t gyro;
  sensors_event_t mag;
  sensors_event_t temp;
  icm.getEvent(&accel, &gyro, &temp, &mag);

  doc["mission_id"] = hostname;
  doc["bus_voltage_v"] = ina260.readBusVoltage() / 1000.0;
  doc["current_ma"] = ina260.readCurrent();
  doc["power_mw"] = ina260.readPower();

  // Print the JSON document to serial for debugging.
  serializeJson(doc, Serial);
  Serial.println();

  // Send the JSON document to the MQTT broker.
  if(!mqtt.connected()){
    reconnect_mqtt();
    if (!mqtt.connected()) {
      return;
    }
  }

  char buffer[256];
  size_t len = serializeJson(doc, buffer, sizeof(buffer));
  if (len == 0) {
    Serial.println("Failed to serialize telemetry payload");
    return;
  }

  if (!mqtt.publish("orbits/telemetry", buffer)) {
    Serial.println("Failed to publish telemetry");
  }
}

void send_imu_data(){
  JsonDocument doc;

  sensors_event_t accel;
  sensors_event_t gyro;
  sensors_event_t mag;
  sensors_event_t temp;
  icm.getEvent(&accel, &gyro, &temp, &mag);

  doc["mission_id"] = hostname;
  doc["accel_x"] = accel.acceleration.x;
  doc["accel_y"] = accel.acceleration.y;
  doc["accel_z"] = accel.acceleration.z;
  doc["gyro_x"] = gyro.gyro.x;
  doc["gyro_y"] = gyro.gyro.y;
  doc["gyro_z"] = gyro.gyro.z;
  doc["mag_x"] = mag.magnetic.x;
  doc["mag_y"] = mag.magnetic.y;
  doc["mag_z"] = mag.magnetic.z;


  //print the JSON document to the serial monitor for debugging
  serializeJson(doc, Serial);
  Serial.println();
  //send the JSON document to the MQTT broker
  if(!mqtt.connected()){
    reconnect_mqtt();
    if (!mqtt.connected()) {
      return;
    }
  }
  char buffer[256];
  serializeJson(doc, buffer);
  mqtt.publish("orbits/imu", buffer);
}

void print_to_serial(const char* message){
  Serial.println(message);
}
