WithASideOfSalt/EE475-ORBITS/(commit log)

2025-11-27 Started Creating an interactible demo to show how the ground station should behave
2026-01-27 Add new project with socketio comms
2026-01-28 2 Way communication using socketio
2026-01-28 Update with new landing page implementation
2026-01-29 Update with boilerplate socketio implementation
2026-04-01 Add 3d model files
    [ORBITS Frame (mm).dwg, ORBITS Frame.iam, Side Panel.ipt, Top&Bottom.ipt]
2026-04-21 update with 3d model, updated diagnostics and working platformio upload
    [ORBITS Frame (mm).dwg, ORBITS Frame.iam, Side Panel.ipt, Top&Bottom.ipt]
